hazy2go/wifi-game-boy-cartridge/README.md

# WiFi Game Boy Cartridge (Rev B)

A WiFi cartridge for the original Game Boy and the Game Boy Color that **can't brown out the console**.
An RP2350 serves the whole cartridge bus, and an ESP32-C3 radio sits behind a power stage. That stage limits what the cart takes from the console to a steady 150 mA and never pulls the console's 5 V rail below 4.588 V.
Fully assembled by JLCPCB, nothing to hand-solder. Designed by Hazy, co-created with RemAI.

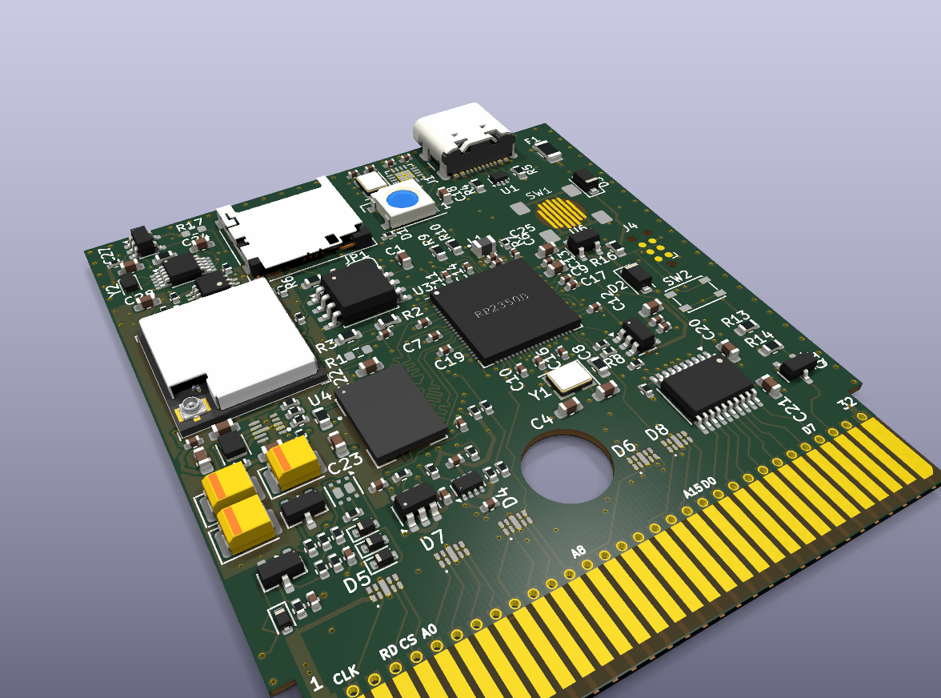
[picture p1: docs/img/board_iso.png]
Rev B board, 3D render


| | |
|---|---|
| Status (2026-10-16) | Hardware design finished, all checks green, JLC order files ready, **not ordered yet**. Bench tests on a XIAO ESP32C3 dev board are under way: RF calibration (about 30 ms at about 60 mA, looks OK), antenna (strong) and the radio app on real WiFi (all commands work) are done; the Pico 2 link test and a power-model update with the measured numbers come next. See `docs/LOGBOOK.md`. |
| Board | 6 layers, 0.8 mm, standard cartridge shell, USB-C |
| Cartridge core | RP2350B + 8 MB HyperRAM + 16 MB flash + microSD + RTC, serving the cartridge bus over PIO (the proven Croco Cartridge design) |
| Radio | ESP32-C3-MINI-1U on the RP2350's SPI bus, stick-on FPC antenna (MHF III plug) inside the shell. Both chips flash over the one USB-C port (built-in USB hub) |
| Power | USB/console power mux → 150 mA current limit → precision input-voltage regulator (console never pulled below 4.588 V ±1 %) → ~1 mF reservoir → power-good → buck-boost to 3.3 V. The radio firmware admits every WiFi frame against the energy left in the reservoir |

## Why

Earlier WiFi carts powered the radio straight from the Game Boy's 5 V. Every transmit burst (170 to 350 mA) hit the console's weak power converter, and on tired batteries the whole system collapsed.
Here the console only ever sees a steady, limited draw. The bursts come out of a local reservoir, and if the console can't keep up, the radio waits instead of the Game Boy crashing.

| Top | Bottom |
|---|---|
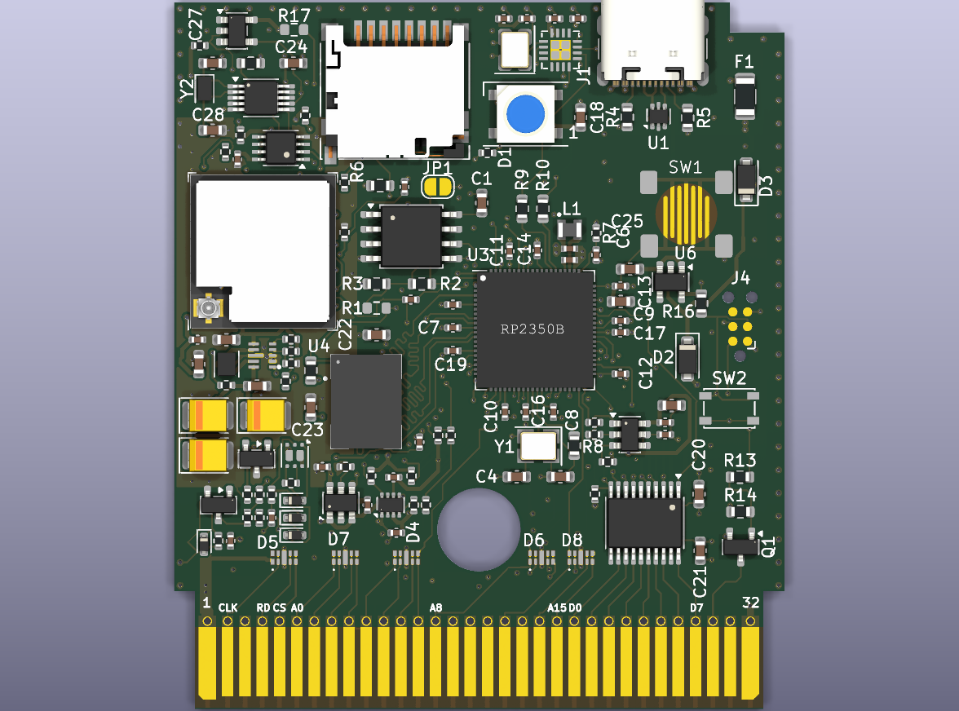
[picture p2: docs/img/board_top.png]
top
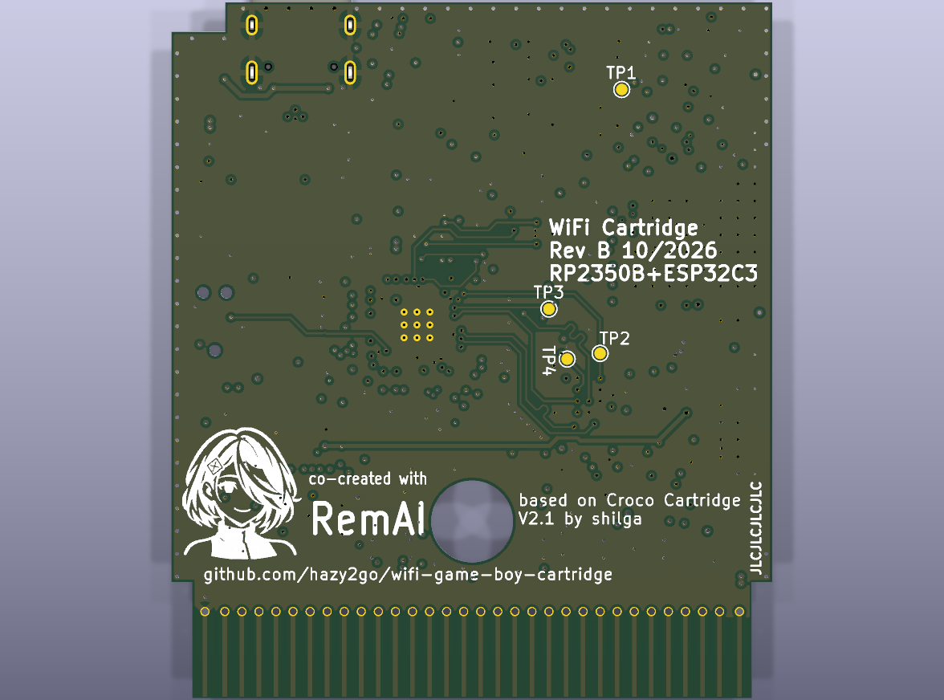
[picture p3: docs/img/board_bottom.png]
bottom
|  |  |

## Proven before ordering

None of this has been built yet. Instead, everything was simulated against real part models and checked against the actual layout:
- **Power stage, at transistor level:** ngspice with TI and Vishay vendor models, covering hot-plug, bursts after idle, loop stability and every tolerance corner (`sim/power`, audits A1 to A8).
- **Full system:** a real Game Boy ROM runs in a cycle-accurate emulator and goes through the cartridge's mailbox. The models cover the RP2350, the ESP32-C3 running the *shipped* power-manager C code, and the power plant including the routed copper's resistance. Tested on fresh, tired and weak batteries (`sim/system`).
- **Layout:**
  - KiCad ERC, DRC and connectivity are clean against the Croco baseline (`verify/`).
  - Every part is checked pin by pin against the exact JLC part.
  - The placement file is derived from JLC's own footprints.

Demo ROM in that simulation: WiFi scan (real networks seen by the host), password entry, then a live BTC/USD chart:

BTC demo running in the simulated cartridge

## Repository

| Path | What |
|---|---|
| `CLAUDE.md` | Handoff: current status, rules, software to-do (start here) |
| `docs/ARCHITECTURE.md` | Block diagram, why each block, pin budget |
| `docs/LOGBOOK.md` | Every decision, check and result, in order |
| `hw/rev-b/` | KiCad project, layout tools, `fab/` order files (`fab/ORDER.md`) |
| `docs/ROM_DEV.md` | **Building ROMs for the cart:** mailbox, commands, timing, testing |
| `gb/gbdk/`, `gb/rgbds/` | WiFi libraries for C (GBDK-2020) and assembly (RGBDS), template, examples |
| `firmware/esp32c3/` | Radio firmware: app, power manager, link protocol, shared C components |
| `firmware/xiao/` | Bench tests for the dev board (calibration time, antenna, boot time) |
| `sim/power/`, `sim/system/` | Power-stage and full-system simulations (`run_rom.py` runs any ROM on the simulated cart) |
| `verify/` | Pre-order gates |
| `legacy/` | The original ESP8266 cartridge's code, PCB and shell, kept for reference only |

## Credits

- Designed by [hazy2go](https://github.com/hazy2go), co-created with RemAI (the avatar on the back of the board).
- Forked from [Staacks/wifi-game-boy-cartridge](https://github.com/Staacks/wifi-game-boy-cartridge) (there.oughta.be). The original ESP8266 cartridge was the idea and the starting point.
- The cartridge core is [Croco Cartridge V2.1](https://github.com/shilga/rp-gameboy-cartridge-hw) by shilga. Firmware base: [rp2350-gameboy-cartridge-firmware](https://github.com/shilga/rp2350-gameboy-cartridge-firmware).
- The emulator in the simulation is [Peanut-GB](https://github.com/deltabeard/Peanut-GB). The DMG power-supply analysis uses [Gekkio's gb-schematics](https://github.com/Gekkio/gb-schematics).

## License

| What | License |
|---|---|
| Hardware design (`hw/rev-b/`: schematic, board, fab files) | CERN-OHL-P v2, inherited from Croco Cartridge (`hw/rev-b/LICENSE-CERN-OHL-P.md`) |
| Everything else here: radio firmware (`firmware/`), Game Boy libraries and examples (`gb/`), simulators (`sim/`), gates (`verify/`), board tools (`hw/rev-b/tools/`), docs | **MIT** (`LICENSE`). Permissive on purpose: ROMs built with the libraries can use any license |
| RP2350 cart firmware ([hazy2go/rp2350-gameboy-cartridge-firmware](https://github.com/hazy2go/rp2350-gameboy-cartridge-firmware)) | GPL-3, as its upstream (Croco) |
| `sim/system/third_party/Peanut-GB` | MIT (one local fix, marked in the code) |
| `sim/system/rom/font8x8_basic.h` (test ROM font) | Public domain (Daniel Hepper, after the IBM VGA font) |
| Vendor SPICE models (TI, Vishay) | Not included: `sim/models/fetch_models.py` downloads them under the vendors' terms |
| `legacy/` | The original project's licenses: GPL-3 for code and PCB, CC-BY-NC-SA for the shell (`legacy/README.md`) |
