hazy2go/wifi-game-boy-cartridge/sim/system/out/report.txt

layout parasitics: -DRPATH=0.0369 -DRESR=0.0156
# S1 full-system simulation: Game Boy ROM -> cartridge mailbox -> RP2350 -> SPI -> ESP32-C3 firmware -> power path

## fresh: console source 0.7 ohm, 12 s simulated
   | WIFI CART TEST
   | PING:
   | PONG
   | TIME (NTP):
   | 2026-10-14 15:00:00
   | GET /hello:
   | Hello from WiFi!
   | POWER:
   | RAIL 4.84V RES 4.82V
   | BURST 20/20 OK
   | POWER:
   | RAIL 4.84V RES 4.82V
   | DONE
PASS  S1.1 fresh screen: all 13 lines as expected
PASS  S1.5 fresh no wrong answer: every printed result correct or explicit ERR/TIMEOUT
PASS  S1.2 fresh console rail: min 4.783 V, 0.0 ms below 4.5 V
PASS  S1.3 fresh radio resets: 0; reservoir min while on 4.20 V
PASS  S1.4 fresh TX through power manager: 129 data frames sent, 129 admitted, refused-ms 0, dropped 0 (TCP retransmit), 5 library frames unadmitted, 1 connects, parks 0

## tired: console source 1.2 ohm, 12 s simulated
   | WIFI CART TEST
   | PING:
   | PONG
   | TIME (NTP):
   | 2026-10-14 15:00:00
   | GET /hello:
   | Hello from WiFi!
   | POWER:
   | RAIL 4.73V RES 4.71V
   | BURST 20/20 OK
   | POWER:
   | RAIL 4.73V RES 4.71V
   | DONE
PASS  S1.1 tired screen: all 13 lines as expected
PASS  S1.5 tired no wrong answer: every printed result correct or explicit ERR/TIMEOUT
PASS  S1.2 tired console rail: min 4.628 V, 0.0 ms below 4.5 V
PASS  S1.3 tired radio resets: 0; reservoir min while on 4.20 V
PASS  S1.4 tired TX through power manager: 129 data frames sent, 129 admitted, refused-ms 0, dropped 0 (TCP retransmit), 5 library frames unadmitted, 1 connects, parks 0

## weak: console source 2.0 ohm, 20 s simulated
   | WIFI CART TEST
   | PING:
   | PONG
   | TIME (NTP):
   | 2026-10-14 15:00:00
   | GET /hello:
   | Hello from WiFi!
   | POWER:
   | RAIL 4.59V RES 3.51V
   | BURST 20/20 OK
   | POWER:
   | RAIL 4.59V RES 3.50V
   | DONE
PASS  S1.1 weak screen: all 13 lines as expected
PASS  S1.5 weak no wrong answer: every printed result correct or explicit ERR/TIMEOUT
PASS  S1.2 weak console rail: min 4.591 V, 0.0 ms below 4.5 V
PASS  S1.3 weak radio resets: 0; reservoir min while on 3.31 V
PASS  S1.4 weak TX through power manager: 129 data frames sent, 129 admitted, refused-ms 1864, dropped 0 (TCP retransmit), 5 library frames unadmitted, 1 connects, parks 0

## weak_plus: console source 2.5 ohm, 60 s simulated
   | WIFI CART TEST
   | PING:
   | ERR
   | TIME (NTP):
   | ERR
   | GET /hello:
   | ERR
   | POWER:
   | ERR
   | BURST FAIL
   | POWER:
   | ERR
   | DONE
INFO  S1.1 weak_plus: not complete; radio resets 107 (boot energy at the default assumption, see weak_plus_fastboot)
PASS  S1.5 weak_plus no wrong answer: every printed result correct or explicit ERR/TIMEOUT
PASS  S1.2 weak_plus console rail: min 4.588 V, 0.0 ms below 4.5 V

## S1.6 SPI link with bit errors on MOSI and MISO (fresh console)
PASS  S1.6 BER 1e-4 screen: 281 bit errors, 463 bad headers, 0 bad bodies, ESP rejected 135, 30 requests re-sent; all 13 lines as expected

## S1.7 a ROM without the WIFICART opt-in gets no mailbox
PASS  S1.7 no opt-in: wifi_rom 0, 0 SPI transactions, 0 cart writes to bank 15
PASS  S1.7 WIFICART with 32 KB RAM: wifi_rom 0, 0 SPI transactions

## S1.8 shipped formatter / TX sizing (components/gbwifi) host test
   | PASS: 0 failures
PASS  S1.8 gbwifi: scan lines <= 19 columns, connect parsing, airtime, power/time/BTC text

## S1.9 GBDK-2020 library (gb/gbdk): demo ROM on the fresh and weak consoles
   | GBDK WIFI DEMO
   | PING:
   | PONG
   | TIME:
   | 2026-10-14 15:00:00
   | GET /hello:
   | Hello from WiFi!
   | POWER:
   | RAIL 4.84V RES 4.82V
   | DONE
PASS  S1.9 gbdk_fresh: screen as expected; console min 4.783 V, resets 0, 9 frames all admitted
   | GBDK WIFI DEMO
   | PING:
   | PONG
   | TIME:
   | 2026-10-14 15:00:00
   | GET /hello:
   | Hello from WiFi!
   | POWER:
   | RAIL 4.59V RES 3.51V
   | DONE
PASS  S1.9 gbdk_weak: screen as expected; console min 4.591 V, resets 0, 9 frames all admitted

## S1.10 ADC error: the reservoir reads 2.5 % high (admission too generous), the rail 1 % high, weak consoles (fast boot, as S1.11)
PASS  S1.10 weak_adc: resets 0, reservoir min 3.19 V, console min 4.591 V
PASS  S1.10 weak_plus_adc: resets 0, reservoir min 2.38 V, console min 4.588 V

## S1.11 weak_plus (2.5 ohm) with a fast ESP boot: 100 ms at 20 mA to app_main (app sdkconfig fast boot; measure on the XIAO)
PASS  S1.11 weak_plus_fastboot: screen complete; resets 0, 129 frames, drops 0, parks 144, console min 4.588 V

## S1.12 developer kit: RGBDS library example and GBDK template through run_rom.py (docs/ROM_DEV.md)
PASS  S1.12 rgbds example (weak): PASS
PASS  S1.12 gbdk template (weak): PASS

RESULT: ALL PASS
