hazy2go/wifi-game-boy-cartridge/docs/img/board_top_after_lift.png

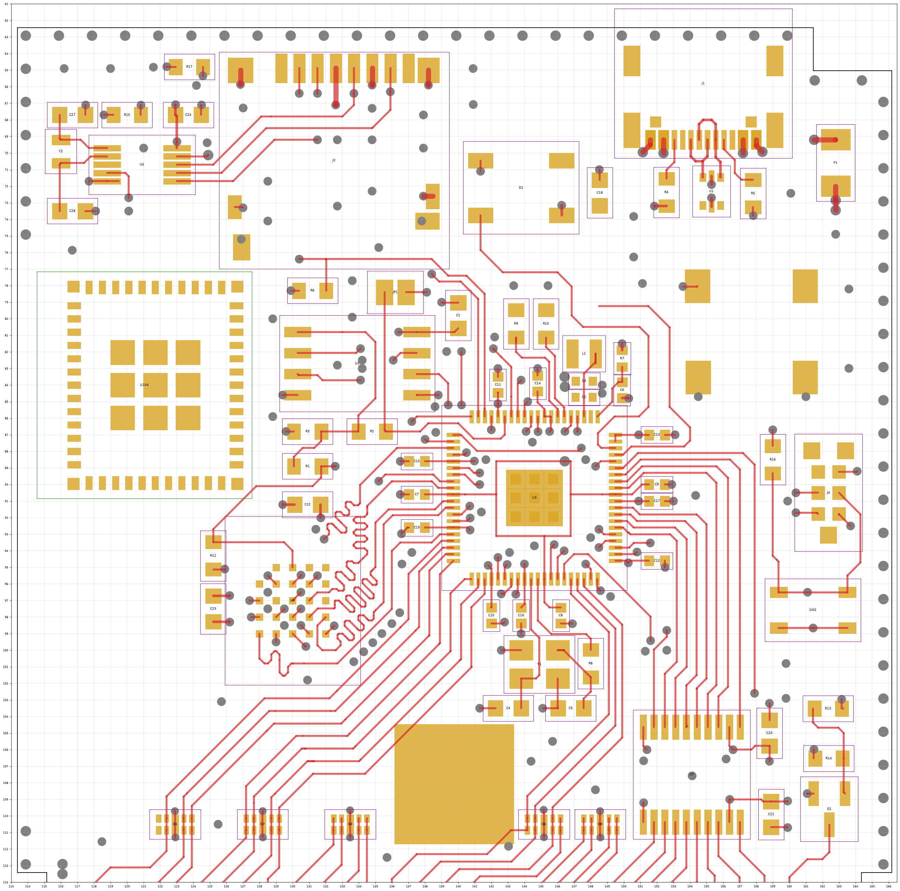
docs/img/board_top_after_lift.png
