hazy2go/wifi-game-boy-cartridge/docs/img/free_space_after_lift.png

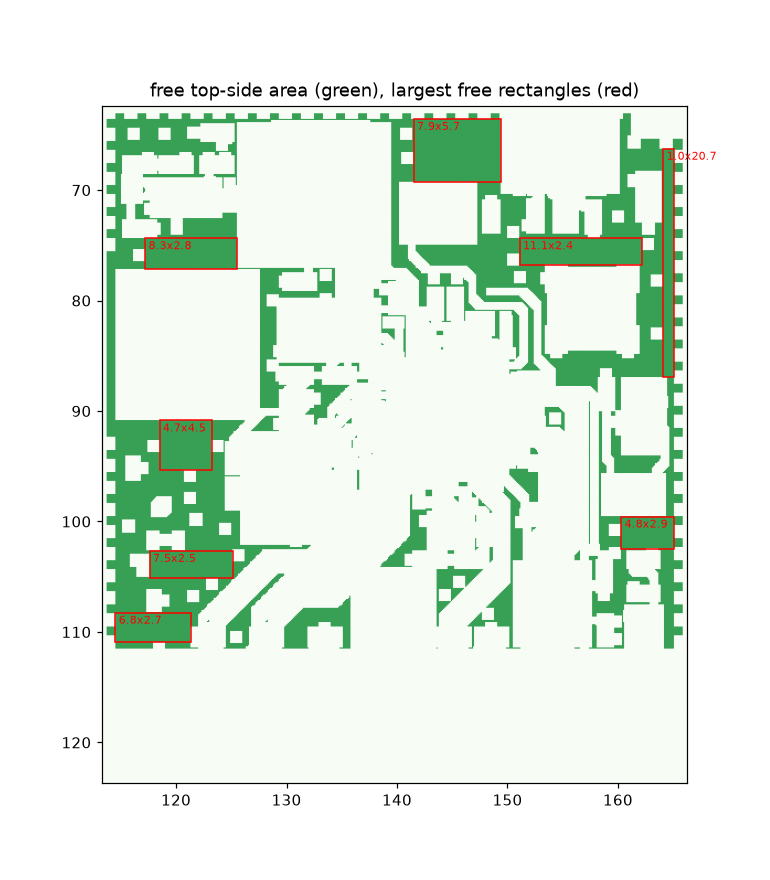
docs/img/free_space_after_lift.png
