hazy2go/wifi-game-boy-cartridge/docs/img/placement_v1.png

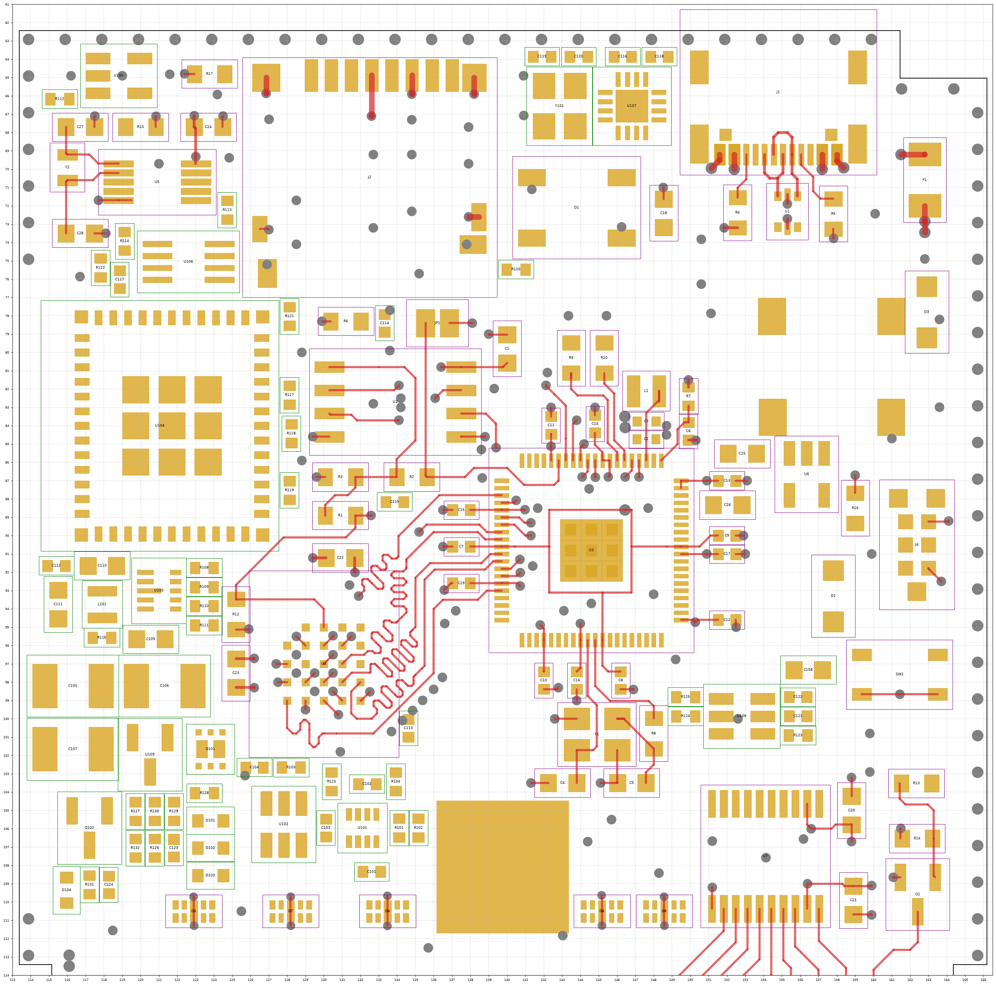
docs/img/placement_v1.png
