hazy2go/wifi-game-boy-cartridge/sim/power/plot_stress_50pct.png

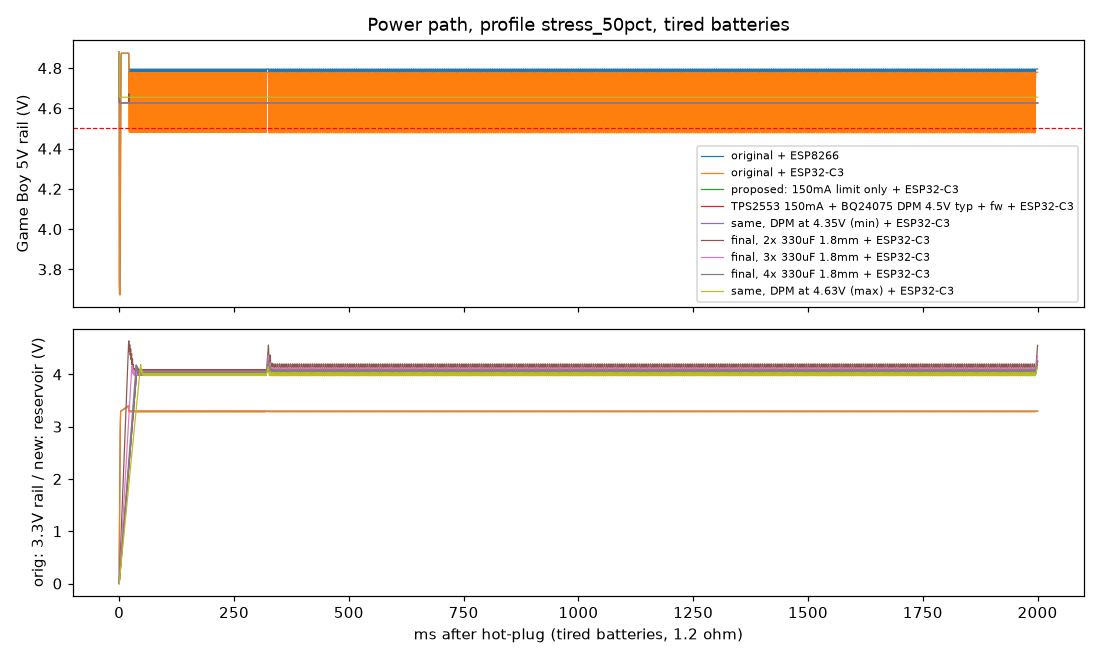
sim/power/plot_stress_50pct.png
