hazy2go/wifi-game-boy-cartridge/sim/power/plot_traffic_2ms_20pct.png

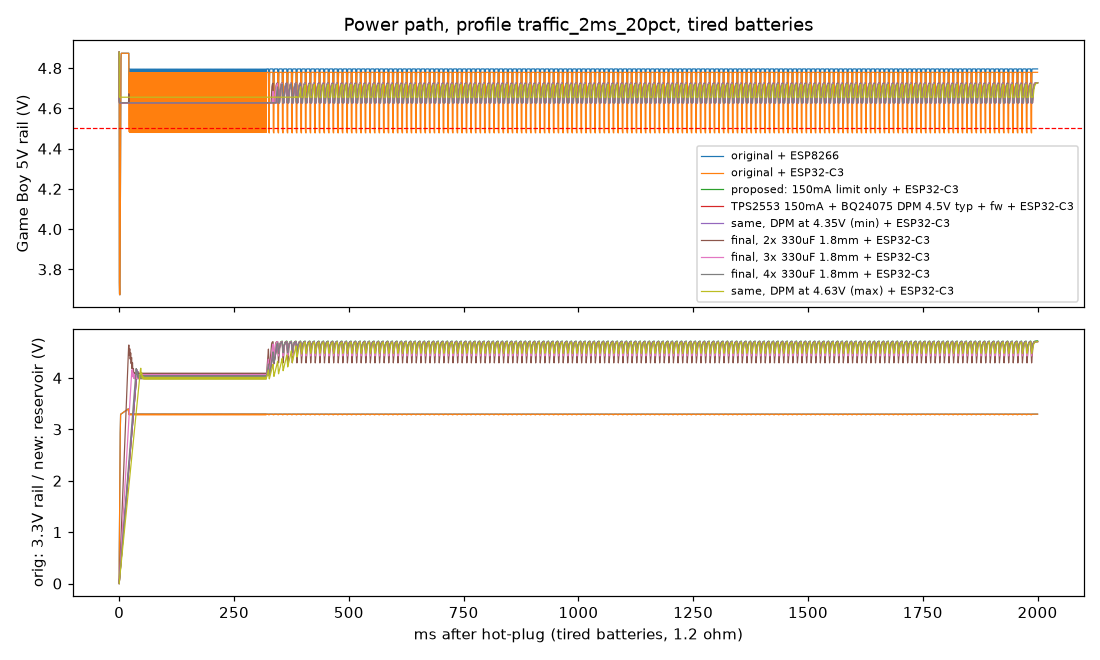
sim/power/plot_traffic_2ms_20pct.png
