hazy2go/wifi-game-boy-cartridge/sim/power/plot_worst_11b_12ms.png

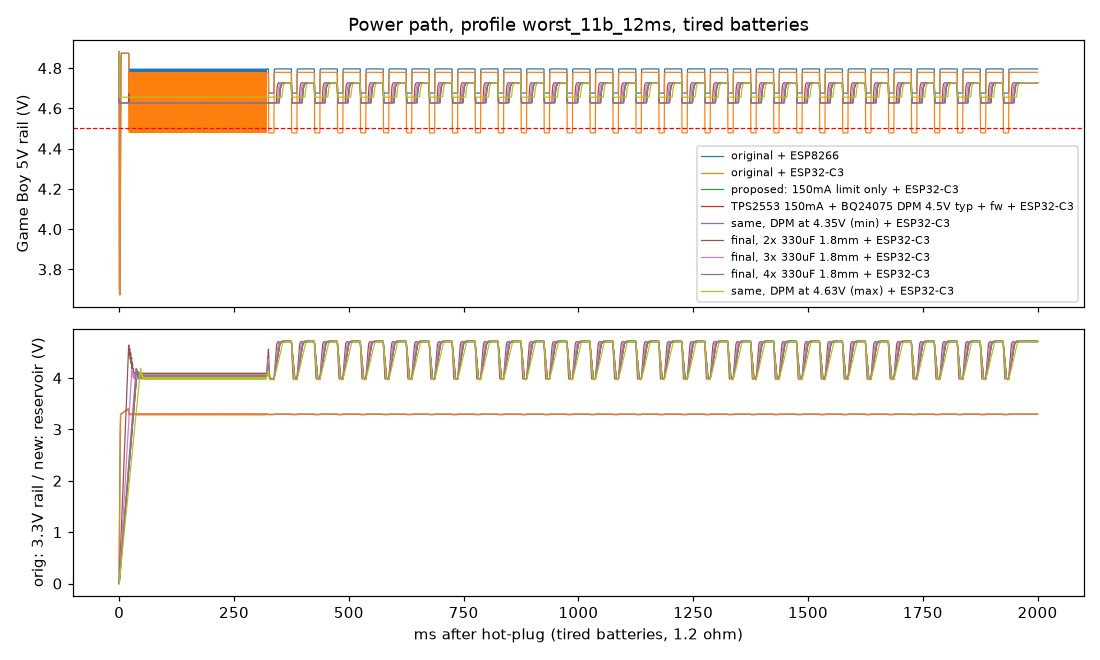
sim/power/plot_worst_11b_12ms.png
