hazy2go/wifi-game-boy-cartridge/sim/system/out/demo_01_s1.png

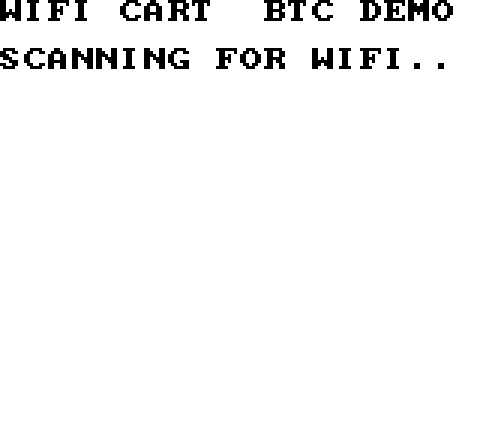
sim/system/out/demo_01_s1.png
