hazy2go/wifi-game-boy-cartridge/sim/system/out/demo_02_s2.png

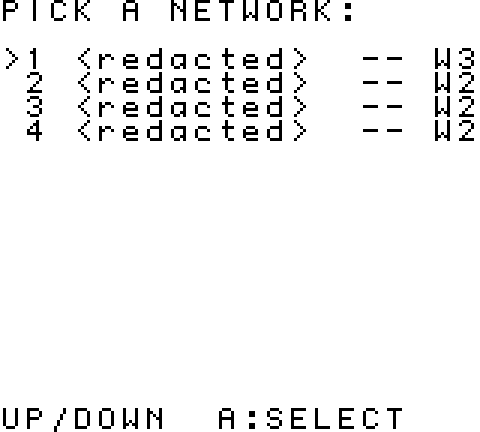
sim/system/out/demo_02_s2.png
