hazy2go/wifi-game-boy-cartridge/sim/system/out/demo_04_s3.png

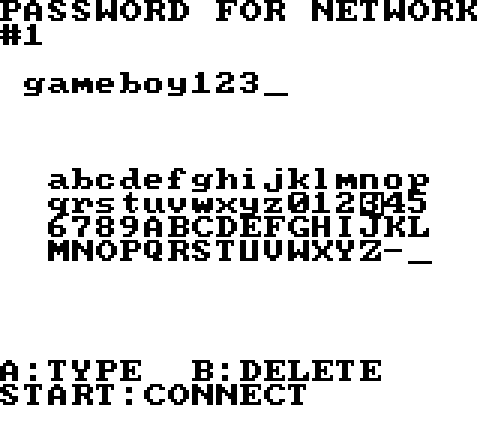
sim/system/out/demo_04_s3.png
