hazy2go/wifi-game-boy-cartridge/sim/system/out/demo_07_s5.png

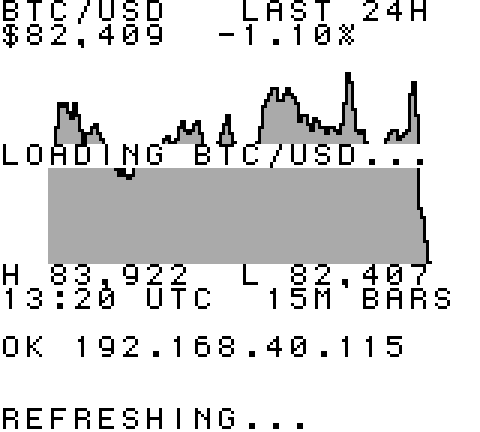
sim/system/out/demo_07_s5.png
