hazy2go/wifi-game-boy-cartridge/sim/system/out/demo_08_s6.png

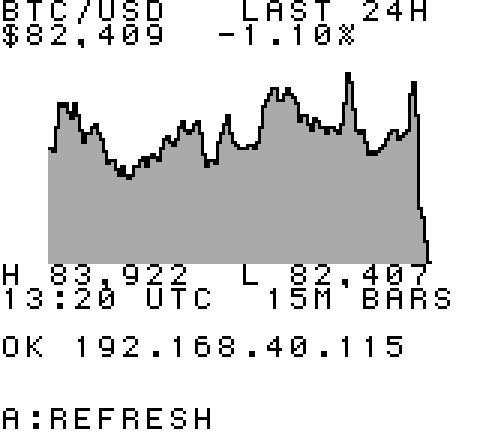
sim/system/out/demo_08_s6.png
