hazy2go/wifi-game-boy-cartridge/sim/system/out/demo_grid.png

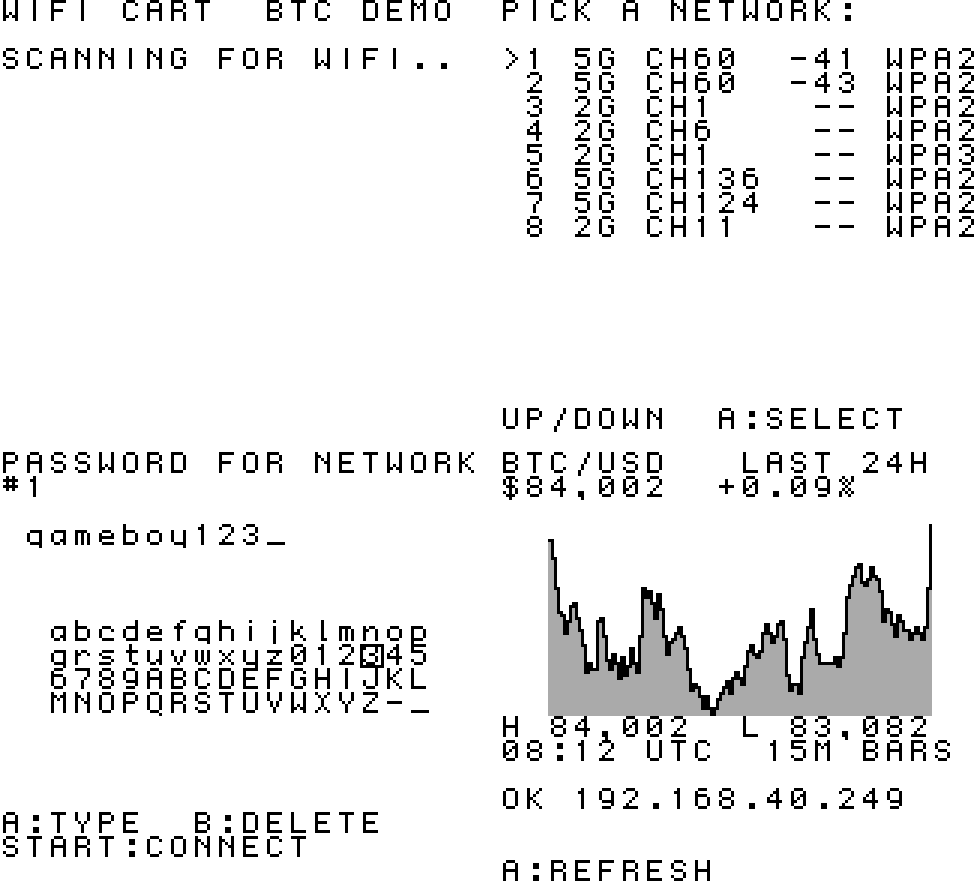
sim/system/out/demo_grid.png
