hazy2go/wifi-game-boy-cartridge/sim/system/out/demo_screen.png

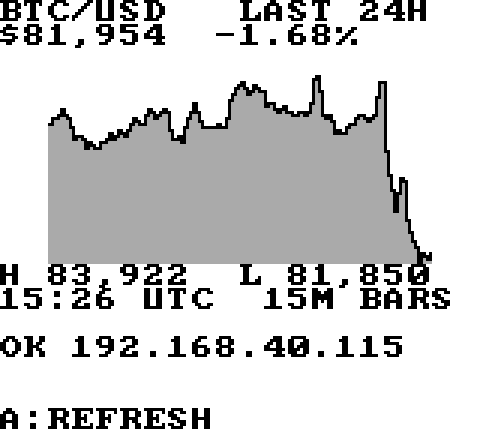
sim/system/out/demo_screen.png
