hazy2go/wifi-game-boy-cartridge/sim/system/out/fresh_screen.png

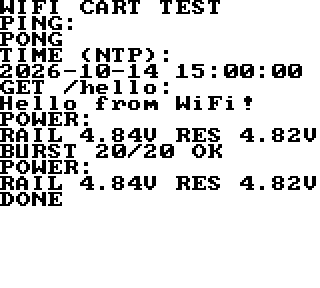
sim/system/out/fresh_screen.png
