hazy2go/wifi-game-boy-cartridge/sim/system/out/kit_template/screen.png

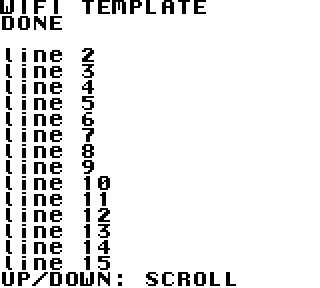
sim/system/out/kit_template/screen.png
