hazy2go/wifi-game-boy-cartridge/sim/system/out/soak_fresh/screen.png

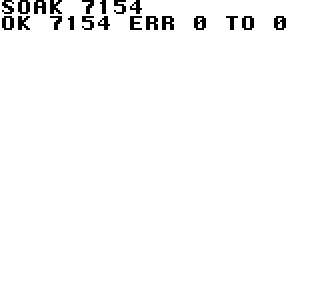
sim/system/out/soak_fresh/screen.png
