hazy2go/wifi-game-boy-cartridge/sim/system/out/tired_screen.png

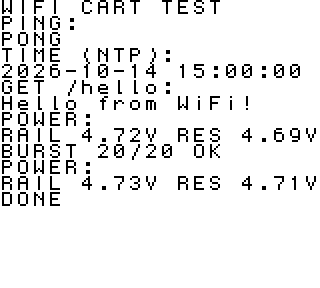
sim/system/out/tired_screen.png
