hazy2go/wifi-game-boy-cartridge/sim/system/out/weak_plus_screen.png

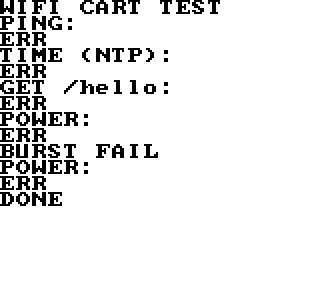
sim/system/out/weak_plus_screen.png
