hazy2go/wifi-game-boy-cartridge/hw/rev-b/fab/GameboyCartridgeV2.1-BOM-JLC.csv

Comment | Designator | Footprint | LCSC Part #
100nF | C1,C18,C20,C21,C22,C23,C24 | C_0603_1608Metric | C14663
4.7u | C2,C3 | C_0402_1005Metric_small_pads | C23733
15pF | C4,C5 | C_0603_1608Metric | C1644
4.7u | C6,C8 | C_0402_1005Metric | C23733
100n | C7,C9,C10,C11,C12,C13,C14,C15,C16,C17,C19 | C_0402_1005Metric | C1525
1uF | C25,C26 | C_0603_1608Metric | C15849
4.3pF | C27,C28 | C_0603_1608Metric | C59526
1uF 25V X5R | C101,C102,C103,C104,C118,C119 | C_0402_1005Metric | C52923
330uF 6.3V 40mOhm T520B337M006ATE040 | C105,C106,C107 | CP_EIA-3528-21_Kemet-B | C696806
10uF 10V X5R | C108,C109,C111 | C_0603_1608Metric | C19702
22uF 6.3V X5R | C110 | C_0603_1608Metric | C59461
100nF 16V X7R | C112,C113,C116,C117,C120,C122,C124 | C_0402_1005Metric | C1525
2.2nF 50V X7R | C114,C115 | C_0402_1005Metric | C84703
10nF 50V X7R | C121 | C_0402_1005Metric | C15195
470pF 50V C0G | C123 | C_0402_1005Metric | C76971
WS2812B | D1 | LED_WS2812B_PLCC4_5.0x5.0mm_P3.2mm | C2761795
D_Schottky | D2,D3 | D_SOD-123F | C669022
1N4148WT | D101,D102,D103,D104 | D_SOD-523 | C27748
Polyfuse | F1 | Fuse_1206_3216Metric | C2649911
USB_C_Receptacle_USB2.0 | J1 | USB_C_Receptacle_GCT_USB4105-xx-A_16P_TopMnt_Horizontal | C2927037
Micro_SD_Card_Det2 | J2 | microSD_HC_Hirose_DM3D-SF | C719027
3.3u | L1 | L_pol_2016 | C42411119
0.47uH 5.5A 26mOhm DFE201612E-R47M | L101 | L_Murata_DFE201610P | C668312
CJ2302 | Q1 | SOT-23 | C8548
SIA975DJ-T1-GE3 | Q101 | Vishay_PowerPAK_SC70-6L_Dual | C141597
2N7002 | Q102 | SOT-23 | C8545
0R | R2 | R_0603_1608Metric | C21189
10k | R3,R6,R12,R14,R15,R16 | R_0603_1608Metric | C25804
5k1 | R4,R5 | R_0603_1608Metric | C23186
33 | R7 | R_0402_1005Metric | C25105
1k | R8,R13 | R_0603_1608Metric | C21190
27R | R9,R10 | R_0603_1608Metric | C25190
1.3k 1% | R101 | R_0402_1005Metric | C25866
510 1% | R102 | R_0402_1005Metric | C25123
180k 1% | R103 | R_0402_1005Metric | C25760
100k 1% | R104,R115 | R_0402_1005Metric | C25741
10k 1% | R108,R111,R112,R113,R114 | R_0402_1005Metric | C25744
511k 1% | R109 | R_0402_1005Metric | C64042
91k 1% | R110 | R_0402_1005Metric | C453777
680k 1% | R116,R118 | R_0402_1005Metric | C4131
200k 1% | R117,R119 | R_0402_1005Metric | C25764
22R 1% | R120,R121 | R_0402_1005Metric | C25092
33R 1% | R122 | R_0402_1005Metric | C25105
1.3M 1% | R123 | R_0402_1005Metric | C423245
1.0M 1% | R124 | R_0402_1005Metric | C26083
1.2M 1% | R125 | R_0402_1005Metric | C43675
27.0k 0.1% | R126 | R_0402_1005Metric | C723421
10.0k 0.1% | R127 | R_0402_1005Metric | C190095
680 1% | R128,R129 | R_0402_1005Metric | C137948
330k 1% | R130 | R_0402_1005Metric | C25778
470k 1% | R131 | R_0402_1005Metric | C25790
1k 1% | R132 | R_0402_1005Metric | C11702
4.7k | R133 | R_0402_1005Metric | C25900
USBLC6-2P6 | U1 | SOT-666 | C2827693
W25Q128JVSIQ | U2 | SOIC-8_5.23x5.23mm_P1.27mm | C97521
RP2350_80QFN | U3 | RP2350-QFN-80-1EP_10x10_P0.4mm_EP3.4x3.4mm_ThermalVias | C42415655
IS66WVH8M8BLL-100B1LI | U4 | BGA25C100P5X5_800X600X120N | C1349096
MCP79510 | U5 | MSOP-10_3x3mm_P0.5mm | C627708
AP2112K-3.3 | U6 | SOT-23-5 | C51118
TXB0108PW | U7 | TSSOP-20_4.4x6.5mm_P0.65mm | C53406
TPS2116DRLR | U101 | SOT-583-8 | C3235557
TPS2553DBVR | U102 | SOT-23-6 | C55266
TPS63802DLAR | U103 | TI_DLA0010A_VSON-HR-10_2x3mm_P0.5mm | C2845237
ESP32-C3-MINI-1U-N4 | U104 | ESP32-C3-MINI-1U | C2911374
SN74LVC1G125DBVR | U105 | SOT-23-5 | C23654
SN74LVC3G34DCTR | U106 | SSOP-8_2.95x2.8mm_P0.65mm | C139356
CH334P | U107 | QFN-16-1EP_3x3mm_P0.5mm_EP1.75x1.75mm | C5373042
TLV3012BIDBVR | U108 | SOT-23-6 | C20345924
TLV431BIDBZR | U109 | SOT-23 | C398375
12MHz | Y1 | Crystal_SMD_TXC_7M-4Pin_3.2x2.5mm | C20625731
32.768kHz | Y2 | Crystal_SMD_TXC_9HT11-2Pin_2.0x1.2mm | C97602
12MHz 10pF | Y101 | Crystal_SMD_3225-4Pin_3.2x2.5mm | C20625731
