hazy2go/wifi-game-boy-cartridge/hw/rev-b/fab/bom_check.txt

BOM check for 2 boards: 72 lines, 130 placed parts, 44 extended parts (feeder fee each), DNP: D4,D5,D6,D7,D8, R1, R17

ok   C14663    base   stock  49892442 need   19  100nF              C1,C18,C20,C21,C22,C23,C24               CC0603KRX7R9BB104      
ok   C23733    base   stock   1837825 need    9  4.7u               C2,C3                                    CL05A475MP5NRNC        
ok   C1644     base   stock    981474 need    9  15pF               C4,C5                                    CL10C150JB8NNNC        
ok   C23733    base   stock   1837825 need    9  4.7u               C6,C8                                    CL05A475MP5NRNC        
ok   C1525     base   stock  22144960 need   27  100n               C7,C9,C10,C11,C12,C13,C14,C15,C16,C17,C1 CL05B104KO5NNNC        
ok   C15849    base   stock   9711805 need    9  1uF                C25,C26                                  CL10A105KB8NNNC        
ok   C59526    expand stock     24714 need    9  4.3pF              C27,C28                                  0603CG4R3C500NT        
ok   C52923    base   stock   9563534 need   17  1uF 25V X5R        C101,C102,C103,C104,C118,C119            CL05A105KA5NQNC        
ok   C696806   expand stock      7913 need   11  330uF 6.3V 40mOhm  C105,C106,C107                           T520B337M006ATE040     
ok   C19702    base   stock  10669029 need   11  10uF 10V X5R       C108,C109,C111                           CL10A106KP8NNNC        
ok   C59461    base   stock   7233393 need    7  22uF 6.3V X5R      C110                                     CL10A226MQ8NRNC        
ok   C1525     base   stock  22144960 need   19  100nF 16V X7R      C112,C113,C116,C117,C120,C122,C124       CL05B104KO5NNNC        
ok   C84703    expand stock     84393 need    9  2.2nF 50V X7R      C114,C115                                CL05B222KB5NNNC        
ok   C15195    base   stock   6309426 need    7  10nF 50V X7R       C121                                     CL05B103KB5NNNC        
ok   C76971    expand stock    374577 need    7  470pF 50V C0G      C123                                     GRM1555C1H471JA01D     
ok   C2761795  expand stock     36809 need    7  WS2812B            D1                                       WS2812B-B/T            
ok   C669022   expand stock      8492 need    9  D_Schottky         D2,D3                                    SM5817PL-TP            
ok   C27748    expand stock     79501 need   13  1N4148WT           D101,D102,D103,D104                      1N4148WT               
ok   C2649911  expand stock      8518 need    7  Polyfuse           F1                                       NANOSMDC050F/13.2-2    
ok   C2927037  expand stock      2336 need    7  USB_C_Receptacle_U J1                                       USB-TYPE-C-017         
ok   C719027   expand stock      4305 need    7  Micro_SD_Card_Det2 J2                                       DM3D-SF                
FAIL C42411119 expand stock         4 need    7  3.3u               L1                                       AOTA-B201610S3R3-101-T STOCK 4 < 7
ok   C668312   expand stock     12140 need    7  0.47uH 5.5A 26mOhm L101                                     DFE201612E-R47M=P2     
ok   C8548     expand stock     62370 need    7  CJ2302             Q1                                       CJ2302 S2              
ok   C141597   expand stock      2692 need    7  SIA975DJ-T1-GE3    Q101                                     SIA975DJ-T1-GE3        
ok   C8545     base   stock   2173372 need    7  2N7002             Q102                                     2N7002                 
ok   C21189    base   stock  23957650 need    7  0R                 R2                                       0603WAF0000T5E         
ok   C25804    base   stock  31846388 need   17  10k                R3,R6,R12,R14,R15,R16                    0603WAF1002T5E         
ok   C23186    base   stock  23703178 need    9  5k1                R4,R5                                    0603WAF5101T5E         
ok   C25105    base   stock   1399209 need    7  33                 R7                                       0402WGF330JTCE         
ok   C21190    base   stock  23875116 need    9  1k                 R8,R13                                   0603WAF1001T5E         
ok   C25190    expand stock     63937 need    9  27R                R9,R10                                   0603WAF270JT5E         
ok   C25866    expand stock     61261 need    7  1.3k 1%            R101                                     0402WGF1301TCE         
ok   C25123    base   stock   1674995 need    7  510 1%             R102                                     0402WGF5100TCE         
ok   C25760    expand stock    171341 need    7  180k 1%            R103                                     0402WGF1803TCE         
ok   C25741    base   stock   9660544 need    9  100k 1%            R104,R115                                0402WGF1003TCE         
ok   C25744    base   stock  21754993 need   15  10k 1%             R108,R111,R112,R113,R114                 0402WGF1002TCE         
ok   C64042    expand stock    168183 need    7  511k 1%            R109                                     0402WGF5113TCE         
ok   C453777   expand stock    119657 need    7  91k 1%             R110                                     RC-02K9102FT           
ok   C4131     expand stock    186832 need    9  680k 1%            R116,R118                                0402WGF6803TCE         
ok   C25764    base   stock   2118449 need    9  200k 1%            R117,R119                                0402WGF2003TCE         
ok   C25092    base   stock   4060234 need    9  22R 1%             R120,R121                                0402WGF220JTCE         
ok   C25105    base   stock   1399209 need    7  33R 1%             R122                                     0402WGF330JTCE         
ok   C423245   expand stock      5439 need    7  1.3M 1%            R123                                     0402WGF1304TCE         
ok   C26083    base   stock   2036818 need    7  1.0M 1%            R124                                     0402WGF1004TCE         
ok   C43675    expand stock     12495 need    7  1.2M 1%            R125                                     0402WGF1204TCE         
ok   C723421   expand stock      4846 need    7  27.0k 0.1%         R126                                     RT0402BRD0727KL        
ok   C190095   expand stock    582253 need    7  10.0k 0.1%         R127                                     RT0402BRD0710KL        
ok   C137948   expand stock    784164 need    9  680 1%             R128,R129                                RC0402FR-07680RL       
ok   C25778    expand stock    129882 need    7  330k 1%            R130                                     0402WGF3303TCE         
ok   C25790    expand stock    183004 need    7  470k 1%            R131                                     0402WGF4703TCE         
ok   C11702    base   stock  14269830 need    7  1k 1%              R132                                     0402WGF1001TCE         
ok   C25900    base   stock  16053025 need    7  4.7k               R133                                     0402WGF4701TCE         
ok   C2827693  expand stock     39298 need    7  USBLC6-2P6         U1                                       USBLC6-2P6             
ok   C97521    base   stock     65890 need    7  W25Q128JVSIQ       U2                                       W25Q128JVSIQ           
ok   C42415655 expand stock      4922 need    7  RP2350_80QFN       U3                                       RP2350B                
ok   C1349096  expand stock       919 need    7  IS66WVH8M8BLL-100B U4                                       IS66WVH8M8BLL-100B1LI  
ok   C627708   expand stock       230 need    7  MCP79510           U5                                       MCP79510T-I/MS         
ok   C51118    expand stock     10508 need    7  AP2112K-3.3        U6                                       AP2112K-3.3TRG1        
ok   C53406    expand stock     28944 need    7  TXB0108PW          U7                                       TXB0108PWR             
ok   C3235557  expand stock     70296 need    7  TPS2116DRLR        U101                                     TPS2116DRLR            
ok   C55266    expand stock     54162 need    7  TPS2553DBVR        U102                                     TPS2553DBVR            
ok   C2845237  expand stock     40342 need    7  TPS63802DLAR       U103                                     TPS63802DLAR           
ok   C2911374  expand stock      1700 need    7  ESP32-C3-MINI-1U-N U104                                     ESP32-C3-MINI-1U-N4    
ok   C23654    expand stock     52783 need    7  SN74LVC1G125DBVR   U105                                     SN74LVC1G125DBVR       
ok   C139356   expand stock      1427 need    7  SN74LVC3G34DCTR    U106                                     SN74LVC3G34DCTR        
ok   C5373042  expand stock     26355 need    7  CH334P             U107                                     CH334P                 
ok   C20345924 expand stock      1854 need    7  TLV3012BIDBVR      U108                                     TLV3012BIDBVR          
ok   C398375   expand stock     14849 need    7  TLV431BIDBZR       U109                                     TLV431BIDBZR           
ok   C20625731 expand stock      6188 need    7  12MHz              Y1                                       ABM8-272-T3            
ok   C97602    expand stock     11540 need    7  32.768kHz          Y2                                       SC-20S,32.768kHz,20PPM 
ok   C20625731 expand stock      6188 need    7  12MHz 10pF         Y101                                     ABM8-272-T3            

RESULT: 1 FAIL
