hazy2go/wifi-game-boy-cartridge/hw/rev-b/CrovoV2.step/TFBGA24_6X8_WIN.step

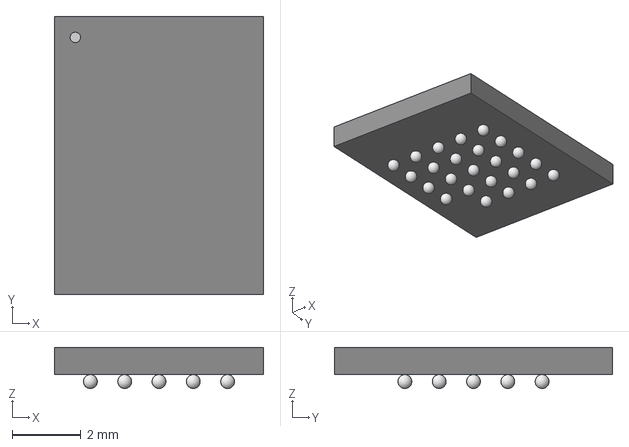
[picture p26: CAD file, 2026-10-14]
hw/rev-b/CrovoV2.step/TFBGA24_6X8_WIN.step
6.10 x 8.10 x 1.20 mm
