hazy2go/wifi-game-boy-cartridge/hw/rev-b/CrovoV2.step/ESD8008MUTAG.step

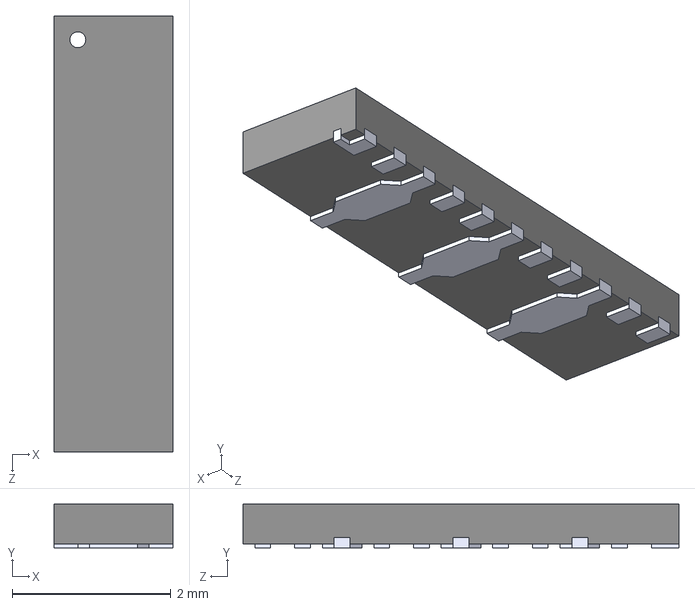
[picture p27: CAD file, 2026-10-13]
hw/rev-b/CrovoV2.step/ESD8008MUTAG.step
1.50 x 0.55 x 5.50 mm
