hazy2go/wifi-game-boy-cartridge/sim/power/results_round4_bq_variants.txt

design    chip      profile            cons   GBmin GB<4.5V ms rail/res min TX delivered radio up ms
original  ESP8266   traffic_2ms_20pct  fresh   4.23        2.5         3.29         100%           -
original  ESP32-C3  traffic_2ms_20pct  fresh   4.23        2.5         3.28         100%           -
lim150    ESP32-C3  traffic_2ms_20pct  fresh   4.78        0.0         3.99          99%          39
dpm45ps   ESP32-C3  traffic_2ms_20pct  fresh   4.78        0.0         3.99          99%          39
bq100     ESP32-C3  traffic_2ms_20pct  fresh   4.82        0.0         3.95          34%          62
bq100lo   ESP32-C3  traffic_2ms_20pct  fresh   4.82        0.0         3.95          34%          62
bq500     ESP32-C3  traffic_2ms_20pct  fresh   4.59        0.0         4.49         100%          14
final     ESP32-C3  traffic_2ms_20pct  fresh   4.78        0.0         3.99          99%          39
final_lo  ESP32-C3  traffic_2ms_20pct  fresh   4.78        0.0         3.99          99%          39
final_hi  ESP32-C3  traffic_2ms_20pct  fresh   4.78        0.0         3.99          99%          39
original  ESP8266   worst_11b_12ms     fresh   4.23        2.5         3.29         100%           -
original  ESP32-C3  worst_11b_12ms     fresh   4.23        2.5         3.28         100%           -
lim150    ESP32-C3  worst_11b_12ms     fresh   4.78        0.0         3.98          80%          39
dpm45ps   ESP32-C3  worst_11b_12ms     fresh   4.78        0.0         3.98          80%          39
bq100     ESP32-C3  worst_11b_12ms     fresh   4.82        0.0         3.93          33%          62
bq100lo   ESP32-C3  worst_11b_12ms     fresh   4.82        0.0         3.93          33%          62
bq500     ESP32-C3  worst_11b_12ms     fresh   4.59        0.0         4.49         100%          14
final     ESP32-C3  worst_11b_12ms     fresh   4.78        0.0         3.98          79%          39
final_lo  ESP32-C3  worst_11b_12ms     fresh   4.78        0.0         3.98          79%          39
final_hi  ESP32-C3  worst_11b_12ms     fresh   4.78        0.0         3.98          79%          39
original  ESP8266   stress_50pct       fresh   4.23        2.5         3.29         100%           -
original  ESP32-C3  stress_50pct       fresh   4.23        2.5         3.28         100%           -
lim150    ESP32-C3  stress_50pct       fresh   4.78        0.0         3.98          62%          39
dpm45ps   ESP32-C3  stress_50pct       fresh   4.78        0.0         3.98          62%          39
bq100     ESP32-C3  stress_50pct       fresh   4.82        0.0         3.94          13%          62
bq100lo   ESP32-C3  stress_50pct       fresh   4.82        0.0         3.94          13%          62
bq500     ESP32-C3  stress_50pct       fresh   4.59        0.0         4.49         100%          14
final     ESP32-C3  stress_50pct       fresh   4.78        0.0         3.98          62%          39
final_lo  ESP32-C3  stress_50pct       fresh   4.78        0.0         3.98          62%          39
final_hi  ESP32-C3  stress_50pct       fresh   4.78        0.0         3.98          62%          39
original  ESP8266   traffic_2ms_20pct  tired   3.67        3.1         3.29         100%           -
original  ESP32-C3  traffic_2ms_20pct  tired   3.67      353.2         3.28         100%           -
lim150    ESP32-C3  traffic_2ms_20pct  tired   4.63        0.0         3.99          99%          39
dpm45ps   ESP32-C3  traffic_2ms_20pct  tired   4.63        0.0         3.99          99%          39
bq100     ESP32-C3  traffic_2ms_20pct  tired   4.69        0.0         3.95          34%          62
bq100lo   ESP32-C3  traffic_2ms_20pct  tired   4.69        0.0         3.95          34%          62
bq500     ESP32-C3  traffic_2ms_20pct  tired   4.54        0.0         4.15         100%          27
final     ESP32-C3  traffic_2ms_20pct  tired   4.63        0.0         3.99          99%          39
final_lo  ESP32-C3  traffic_2ms_20pct  tired   4.63        0.0         3.99          99%          39
final_hi  ESP32-C3  traffic_2ms_20pct  tired   4.66        0.0         3.98          98%          46
original  ESP8266   worst_11b_12ms     tired   3.67        3.1         3.29         100%           -
original  ESP32-C3  worst_11b_12ms     tired   3.67      473.0         3.28         100%           -
lim150    ESP32-C3  worst_11b_12ms     tired   4.63        0.0         3.98          72%          39
dpm45ps   ESP32-C3  worst_11b_12ms     tired   4.63        0.0         3.98          72%          39
bq100     ESP32-C3  worst_11b_12ms     tired   4.69        0.0         3.93          33%          62
bq100lo   ESP32-C3  worst_11b_12ms     tired   4.69        0.0         3.93          33%          62
bq500     ESP32-C3  worst_11b_12ms     tired   4.54        0.0         4.03          99%          27
final     ESP32-C3  worst_11b_12ms     tired   4.63        0.0         3.98          71%          39
final_lo  ESP32-C3  worst_11b_12ms     tired   4.63        0.0         3.98          71%          39
final_hi  ESP32-C3  worst_11b_12ms     tired   4.66        0.0         3.97          61%          46
original  ESP8266   stress_50pct       tired   3.67        3.1         3.29         100%           -
original  ESP32-C3  stress_50pct       tired   3.67      747.0         3.28         100%           -
lim150    ESP32-C3  stress_50pct       tired   4.63        0.0         3.98          62%          39
dpm45ps   ESP32-C3  stress_50pct       tired   4.63        0.0         3.98          62%          39
bq100     ESP32-C3  stress_50pct       tired   4.69        0.0         3.94          13%          62
bq100lo   ESP32-C3  stress_50pct       tired   4.69        0.0         3.94          13%          62
bq500     ESP32-C3  stress_50pct       tired   4.54        0.0         4.15         100%          27
final     ESP32-C3  stress_50pct       tired   4.63        0.0         3.98          62%          39
final_lo  ESP32-C3  stress_50pct       tired   4.63        0.0         3.98          62%          39
final_hi  ESP32-C3  stress_50pct       tired   4.66        0.0         3.97          41%          46
original  ESP8266   traffic_2ms_20pct  weak    2.80      386.8         3.29         100%           -
original  ESP32-C3  traffic_2ms_20pct  weak    2.80      782.7         3.11         100%           -
lim150    ESP32-C3  traffic_2ms_20pct  weak    4.39     1625.7         3.99          99%          41
dpm45ps   ESP32-C3  traffic_2ms_20pct  weak    4.54        0.0         3.52           0%          81
bq100     ESP32-C3  traffic_2ms_20pct  weak    4.52        0.0         3.55           0%          71
bq100lo   ESP32-C3  traffic_2ms_20pct  weak    4.49     1999.3         3.95          34%          62
bq500     ESP32-C3  traffic_2ms_20pct  weak    4.51        0.0         3.55           0%          71
final     ESP32-C3  traffic_2ms_20pct  weak    4.52        0.0         3.55           0%          71
final_lo  ESP32-C3  traffic_2ms_20pct  weak    4.39     1678.5         3.99          99%          41
final_hi  ESP32-C3  traffic_2ms_20pct  weak    4.63        0.0         2.06           0%         257
original  ESP8266   worst_11b_12ms     weak    2.80      491.7         3.29         100%           -
original  ESP32-C3  worst_11b_12ms     weak    2.80      716.5         3.01         100%           -
lim150    ESP32-C3  worst_11b_12ms     weak    4.39     1129.6         3.97          57%          41
dpm45ps   ESP32-C3  worst_11b_12ms     weak    4.54        0.0         3.52           0%          81
bq100     ESP32-C3  worst_11b_12ms     weak    4.52        0.0         3.55           0%          71
bq100lo   ESP32-C3  worst_11b_12ms     weak    4.49     1976.0         3.93          33%          62
bq500     ESP32-C3  worst_11b_12ms     weak    4.51        0.0         3.55           0%          71
final     ESP32-C3  worst_11b_12ms     weak    4.52        0.0         3.55           0%          71
final_lo  ESP32-C3  worst_11b_12ms     weak    4.39     1123.0         3.97          56%          41
final_hi  ESP32-C3  worst_11b_12ms     weak    4.63        0.0         2.06           0%         257
original  ESP8266   stress_50pct       weak    2.80      808.5         3.29         100%           -
original  ESP32-C3  stress_50pct       weak    2.80     1555.8         3.11         100%           -
lim150    ESP32-C3  stress_50pct       weak    4.39     1999.7         3.98          55%          41
dpm45ps   ESP32-C3  stress_50pct       weak    4.54        0.0         3.52           0%          81
bq100     ESP32-C3  stress_50pct       weak    4.52        0.0         3.55           0%          71
bq100lo   ESP32-C3  stress_50pct       weak    4.49     1999.3         3.94          13%          62
bq500     ESP32-C3  stress_50pct       weak    4.51        0.0         3.55           0%          71
final     ESP32-C3  stress_50pct       weak    4.52        0.0         3.55           0%          71
final_lo  ESP32-C3  stress_50pct       weak    4.39     1999.7         3.98          55%          41
final_hi  ESP32-C3  stress_50pct       weak    4.63        0.0         2.06           0%         257
