hazy2go/wifi-game-boy-cartridge/sim/power/out/results.txt

design    chip      profile            cons   GBmin GB<4.5V ms rail/res min TX delivered radio up ms
original  ESP8266   traffic_2ms_20pct  fresh   4.23        2.5         3.29         100%           -
original  ESP32-C3  traffic_2ms_20pct  fresh   4.23        2.5         3.28         100%           -
lim150    ESP32-C3  traffic_2ms_20pct  fresh   4.78        0.0         3.99          99%          39
final     ESP32-C3  traffic_2ms_20pct  fresh   4.78        0.0         3.99          99%          39
final_lo  ESP32-C3  traffic_2ms_20pct  fresh   4.78        0.0         3.99          99%          39
c660      ESP32-C3  traffic_2ms_20pct  fresh   4.78        0.0         3.98          99%          18
c990      ESP32-C3  traffic_2ms_20pct  fresh   4.78        0.0         3.99          99%          27
c1320     ESP32-C3  traffic_2ms_20pct  fresh   4.78        0.0         3.99          99%          37
final_hi  ESP32-C3  traffic_2ms_20pct  fresh   4.78        0.0         3.99          99%          39
original  ESP8266   worst_11b_12ms     fresh   4.23        2.5         3.29         100%           -
original  ESP32-C3  worst_11b_12ms     fresh   4.23        2.5         3.28         100%           -
lim150    ESP32-C3  worst_11b_12ms     fresh   4.78        0.0         3.98          80%          39
final     ESP32-C3  worst_11b_12ms     fresh   4.78        0.0         3.98          79%          39
final_lo  ESP32-C3  worst_11b_12ms     fresh   4.78        0.0         3.98          79%          39
c660      ESP32-C3  worst_11b_12ms     fresh   4.78        0.0         3.98          54%          18
c990      ESP32-C3  worst_11b_12ms     fresh   4.78        0.0         3.98          65%          27
c1320     ESP32-C3  worst_11b_12ms     fresh   4.78        0.0         3.98          76%          37
final_hi  ESP32-C3  worst_11b_12ms     fresh   4.78        0.0         3.98          79%          39
original  ESP8266   stress_50pct       fresh   4.23        2.5         3.29         100%           -
original  ESP32-C3  stress_50pct       fresh   4.23        2.5         3.28         100%           -
lim150    ESP32-C3  stress_50pct       fresh   4.78        0.0         3.98          62%          39
final     ESP32-C3  stress_50pct       fresh   4.78        0.0         3.98          62%          39
final_lo  ESP32-C3  stress_50pct       fresh   4.78        0.0         3.98          62%          39
c660      ESP32-C3  stress_50pct       fresh   4.78        0.0         3.98          63%          18
c990      ESP32-C3  stress_50pct       fresh   4.78        0.0         3.98          62%          27
c1320     ESP32-C3  stress_50pct       fresh   4.78        0.0         3.98          62%          37
final_hi  ESP32-C3  stress_50pct       fresh   4.78        0.0         3.98          62%          39
original  ESP8266   traffic_2ms_20pct  tired   3.67        3.1         3.29         100%           -
original  ESP32-C3  traffic_2ms_20pct  tired   3.67      353.2         3.28         100%           -
lim150    ESP32-C3  traffic_2ms_20pct  tired   4.63        0.0         3.99          99%          39
final     ESP32-C3  traffic_2ms_20pct  tired   4.63        0.0         3.99          99%          39
final_lo  ESP32-C3  traffic_2ms_20pct  tired   4.63        0.0         3.99          99%          39
c660      ESP32-C3  traffic_2ms_20pct  tired   4.63        0.0         3.98          99%          18
c990      ESP32-C3  traffic_2ms_20pct  tired   4.63        0.0         3.99          99%          27
c1320     ESP32-C3  traffic_2ms_20pct  tired   4.63        0.0         3.99          99%          37
final_hi  ESP32-C3  traffic_2ms_20pct  tired   4.66        0.0         3.98          98%          46
original  ESP8266   worst_11b_12ms     tired   3.67        3.1         3.29         100%           -
original  ESP32-C3  worst_11b_12ms     tired   3.67      473.0         3.28         100%           -
lim150    ESP32-C3  worst_11b_12ms     tired   4.63        0.0         3.98          72%          39
final     ESP32-C3  worst_11b_12ms     tired   4.63        0.0         3.98          71%          39
final_lo  ESP32-C3  worst_11b_12ms     tired   4.63        0.0         3.98          71%          39
c660      ESP32-C3  worst_11b_12ms     tired   4.63        0.0         3.98          50%          18
c990      ESP32-C3  worst_11b_12ms     tired   4.63        0.0         3.98          59%          27
c1320     ESP32-C3  worst_11b_12ms     tired   4.63        0.0         3.98          68%          37
final_hi  ESP32-C3  worst_11b_12ms     tired   4.66        0.0         3.97          61%          46
original  ESP8266   stress_50pct       tired   3.67        3.1         3.29         100%           -
original  ESP32-C3  stress_50pct       tired   3.67      747.0         3.28         100%           -
lim150    ESP32-C3  stress_50pct       tired   4.63        0.0         3.98          62%          39
final     ESP32-C3  stress_50pct       tired   4.63        0.0         3.98          62%          39
final_lo  ESP32-C3  stress_50pct       tired   4.63        0.0         3.98          62%          39
c660      ESP32-C3  stress_50pct       tired   4.63        0.0         3.98          63%          18
c990      ESP32-C3  stress_50pct       tired   4.63        0.0         3.98          62%          27
c1320     ESP32-C3  stress_50pct       tired   4.63        0.0         3.98          62%          37
final_hi  ESP32-C3  stress_50pct       tired   4.66        0.0         3.97          41%          46
original  ESP8266   traffic_2ms_20pct  weak    2.80      386.8         3.29         100%           -
original  ESP32-C3  traffic_2ms_20pct  weak    2.80      782.7         3.11         100%           -
lim150    ESP32-C3  traffic_2ms_20pct  weak    4.39     1625.7         3.99          99%          41
final     ESP32-C3  traffic_2ms_20pct  weak    4.52        0.0         4.19           6%          71
final_lo  ESP32-C3  traffic_2ms_20pct  weak    4.46       57.0         4.22           6%          52
c660      ESP32-C3  traffic_2ms_20pct  weak    4.52        0.0         4.25           3%          33
c990      ESP32-C3  traffic_2ms_20pct  weak    4.52        0.0         4.22           5%          50
c1320     ESP32-C3  traffic_2ms_20pct  weak    4.52        0.0         4.20           6%          67
final_hi  ESP32-C3  traffic_2ms_20pct  weak    4.63        0.0         2.06           0%         257
original  ESP8266   worst_11b_12ms     weak    2.80      491.7         3.29         100%           -
original  ESP32-C3  worst_11b_12ms     weak    2.80      716.5         3.01         100%           -
lim150    ESP32-C3  worst_11b_12ms     weak    4.39     1129.6         3.97          57%          41
final     ESP32-C3  worst_11b_12ms     weak    4.52        0.0         4.19           1%          71
final_lo  ESP32-C3  worst_11b_12ms     weak    4.46       57.0         4.22           1%          52
c660      ESP32-C3  worst_11b_12ms     weak    4.52        0.0         4.25           1%          33
c990      ESP32-C3  worst_11b_12ms     weak    4.52        0.0         4.22           1%          50
c1320     ESP32-C3  worst_11b_12ms     weak    4.52        0.0         4.20           1%          67
final_hi  ESP32-C3  worst_11b_12ms     weak    4.63        0.0         2.06           0%         257
original  ESP8266   stress_50pct       weak    2.80      808.5         3.29         100%           -
original  ESP32-C3  stress_50pct       weak    2.80     1555.8         3.11         100%           -
lim150    ESP32-C3  stress_50pct       weak    4.39     1999.7         3.98          55%          41
final     ESP32-C3  stress_50pct       weak    4.52        0.0         4.19           6%          71
final_lo  ESP32-C3  stress_50pct       weak    4.46       57.0         4.22           6%          52
c660      ESP32-C3  stress_50pct       weak    4.52        0.0         4.25           3%          33
c990      ESP32-C3  stress_50pct       weak    4.52        0.0         4.22           4%          50
c1320     ESP32-C3  stress_50pct       weak    4.52        0.0         4.20           5%          67
final_hi  ESP32-C3  stress_50pct       weak    4.63        0.0         2.06           0%         257
