hazy2go/wifi-game-boy-cartridge/hw/rev-b/GameboyCartridgeV2.1-RevB-schematic.pdf

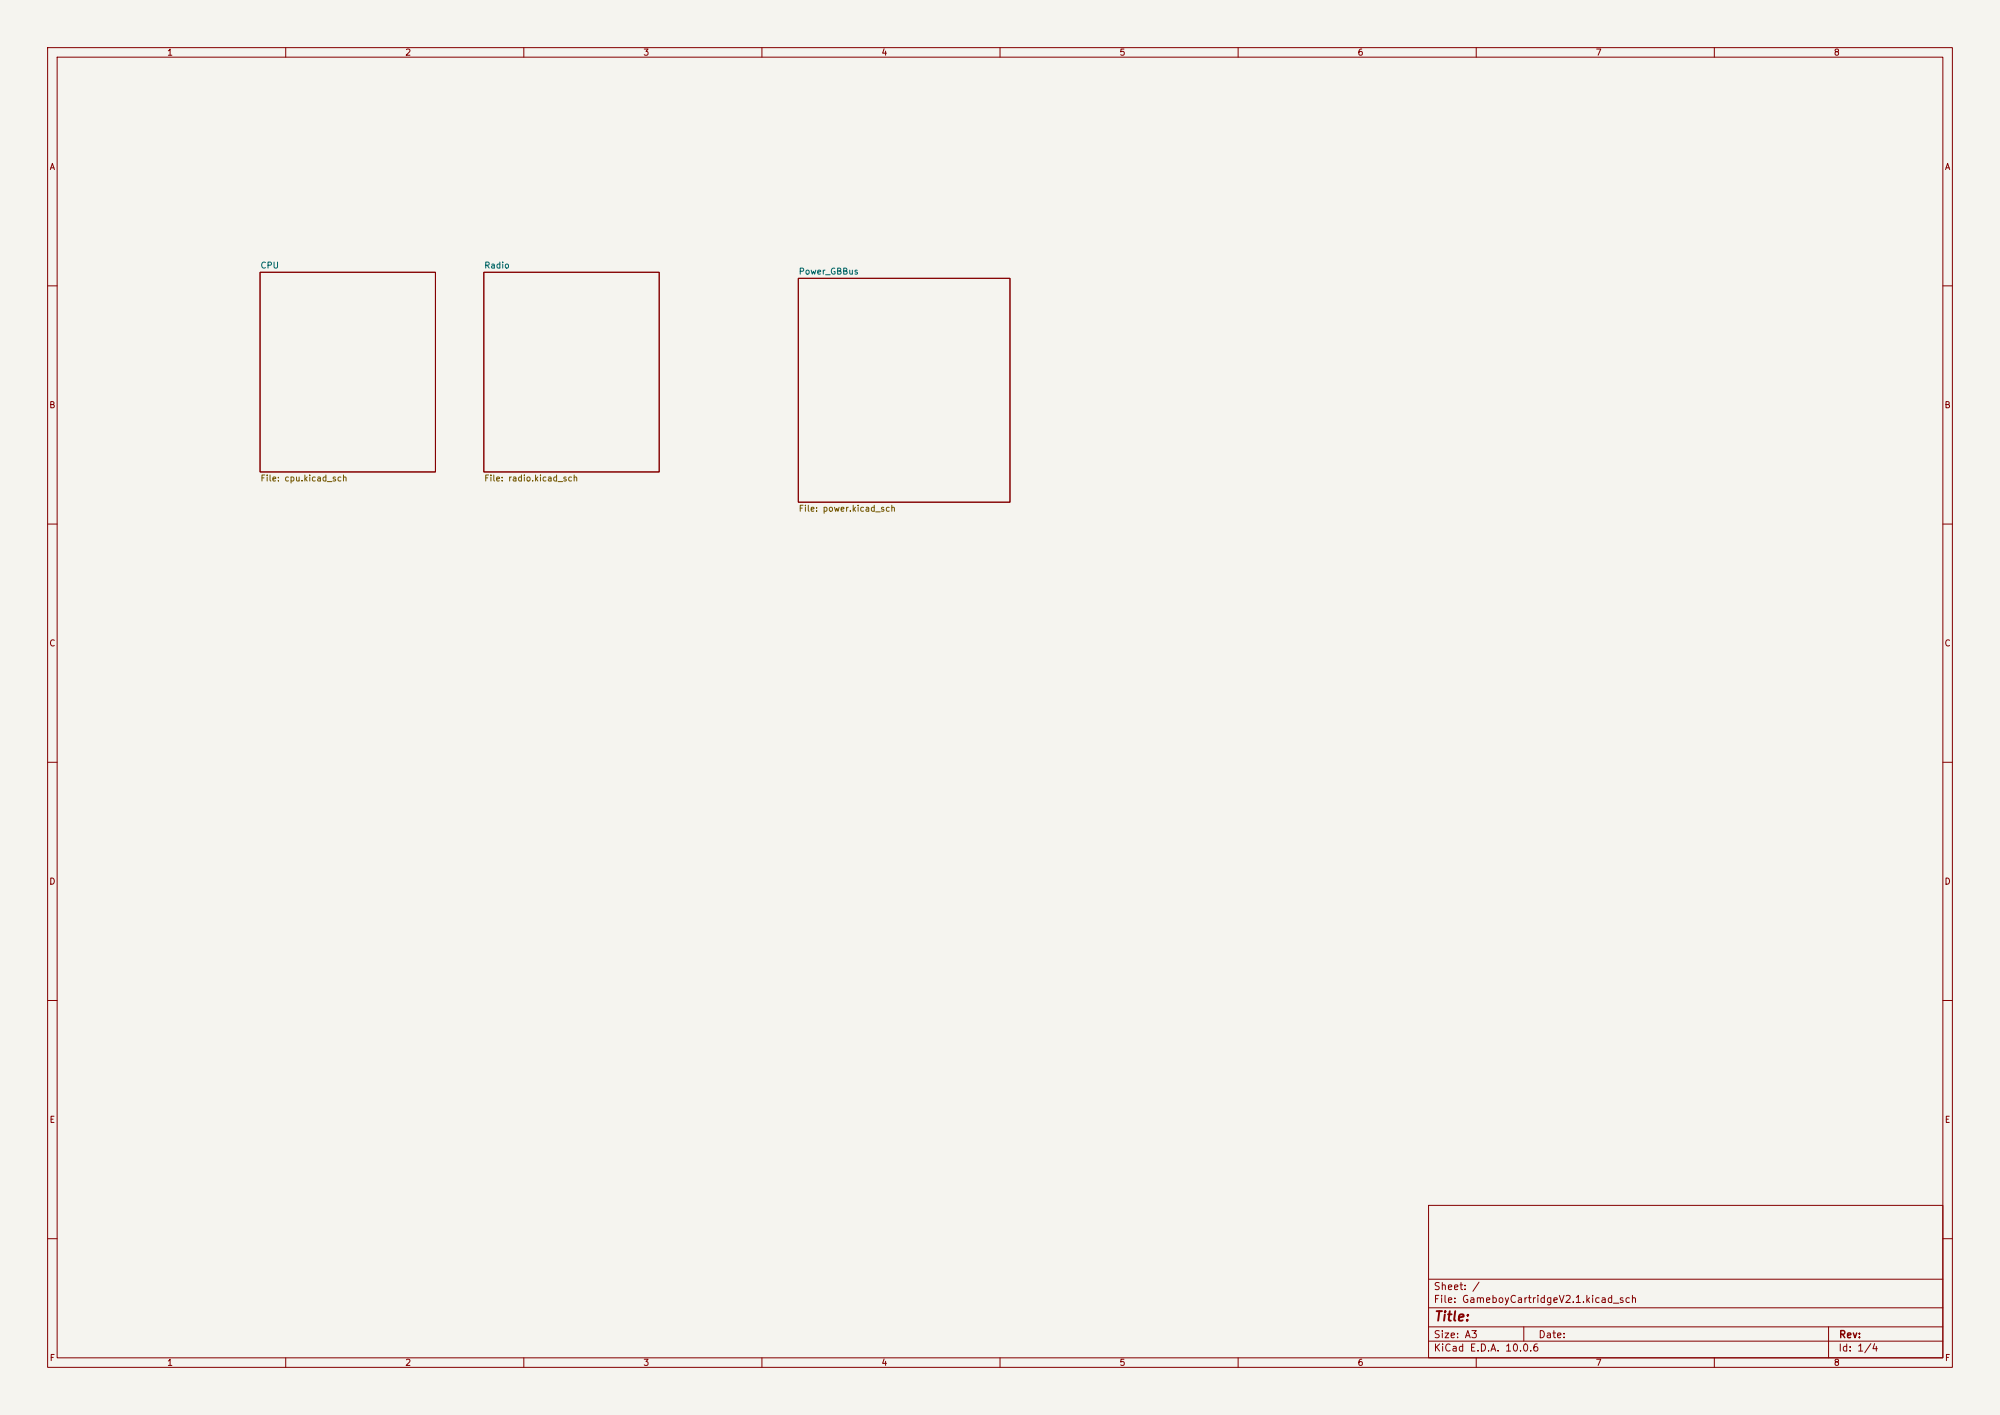
[picture p37: page 1]

Size: A3 | Rev: | F Date:
KiCad E.D.A. 10.0.6 | Id: 1/4

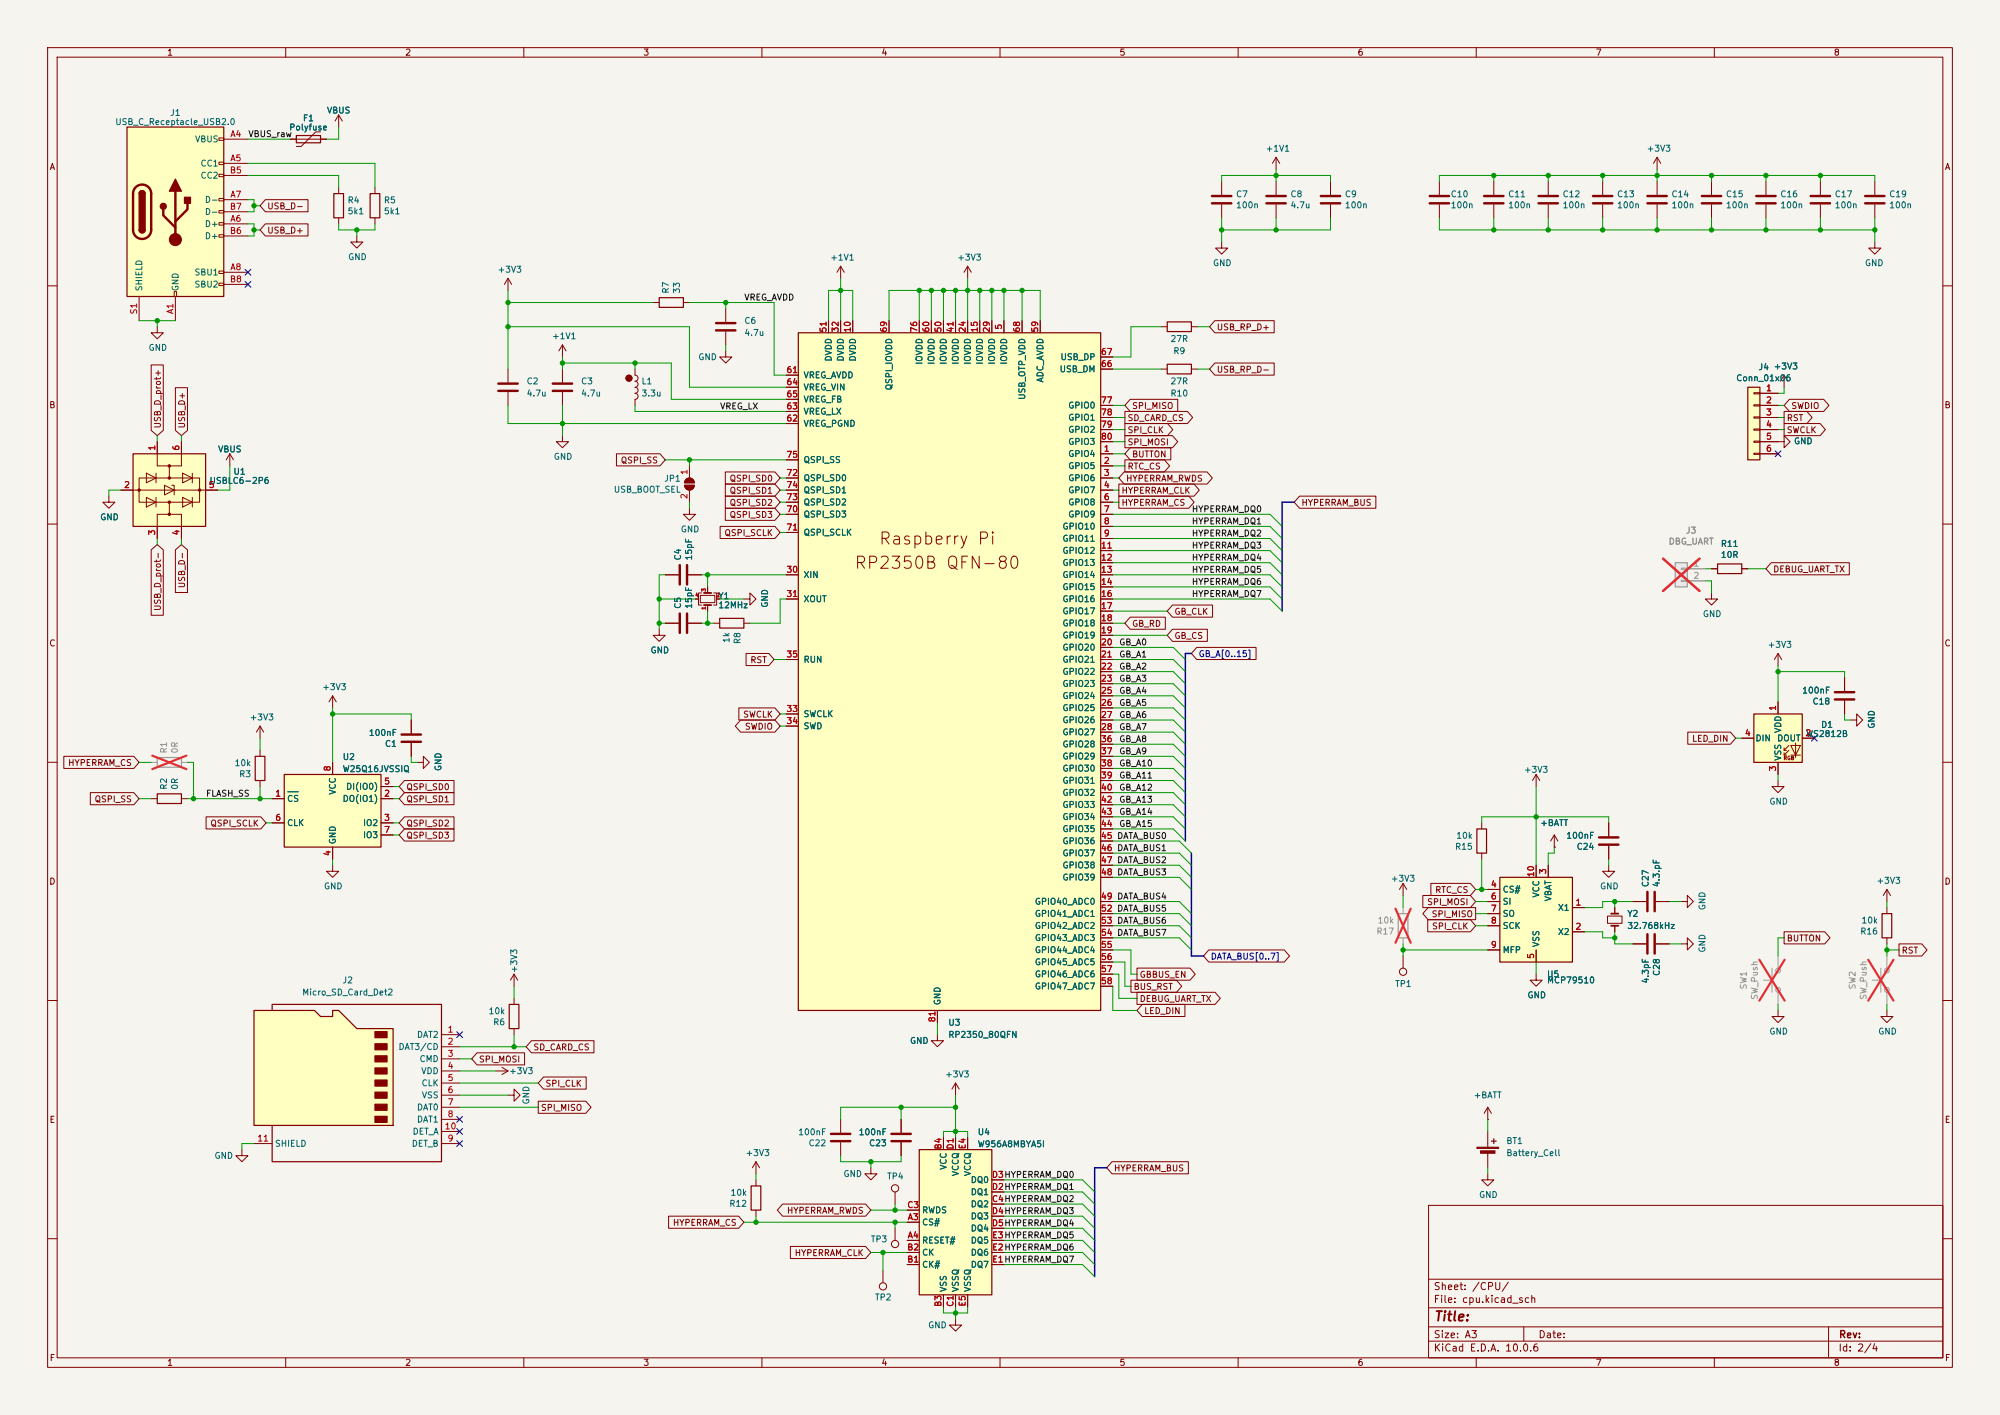
[picture p38: page 2]

5 GPIO8 6 GPIO9 7 GPIO10 8 GPIO11 9 DVDD 10 GPIO12 11 GPIO13 12 GPIO14 13 GPIO15 14 IOVDD 15 GPIO16 16 GPIO17 17 GPIO18 18 GPIO19 19 GPIO20 20 GPIO21 21 GPIO22 22 GPIO23 23 IOVDD 24 GPIO24 25 GPIO25 26 GPIO26 27 GPIO27 28 IOVDD 29

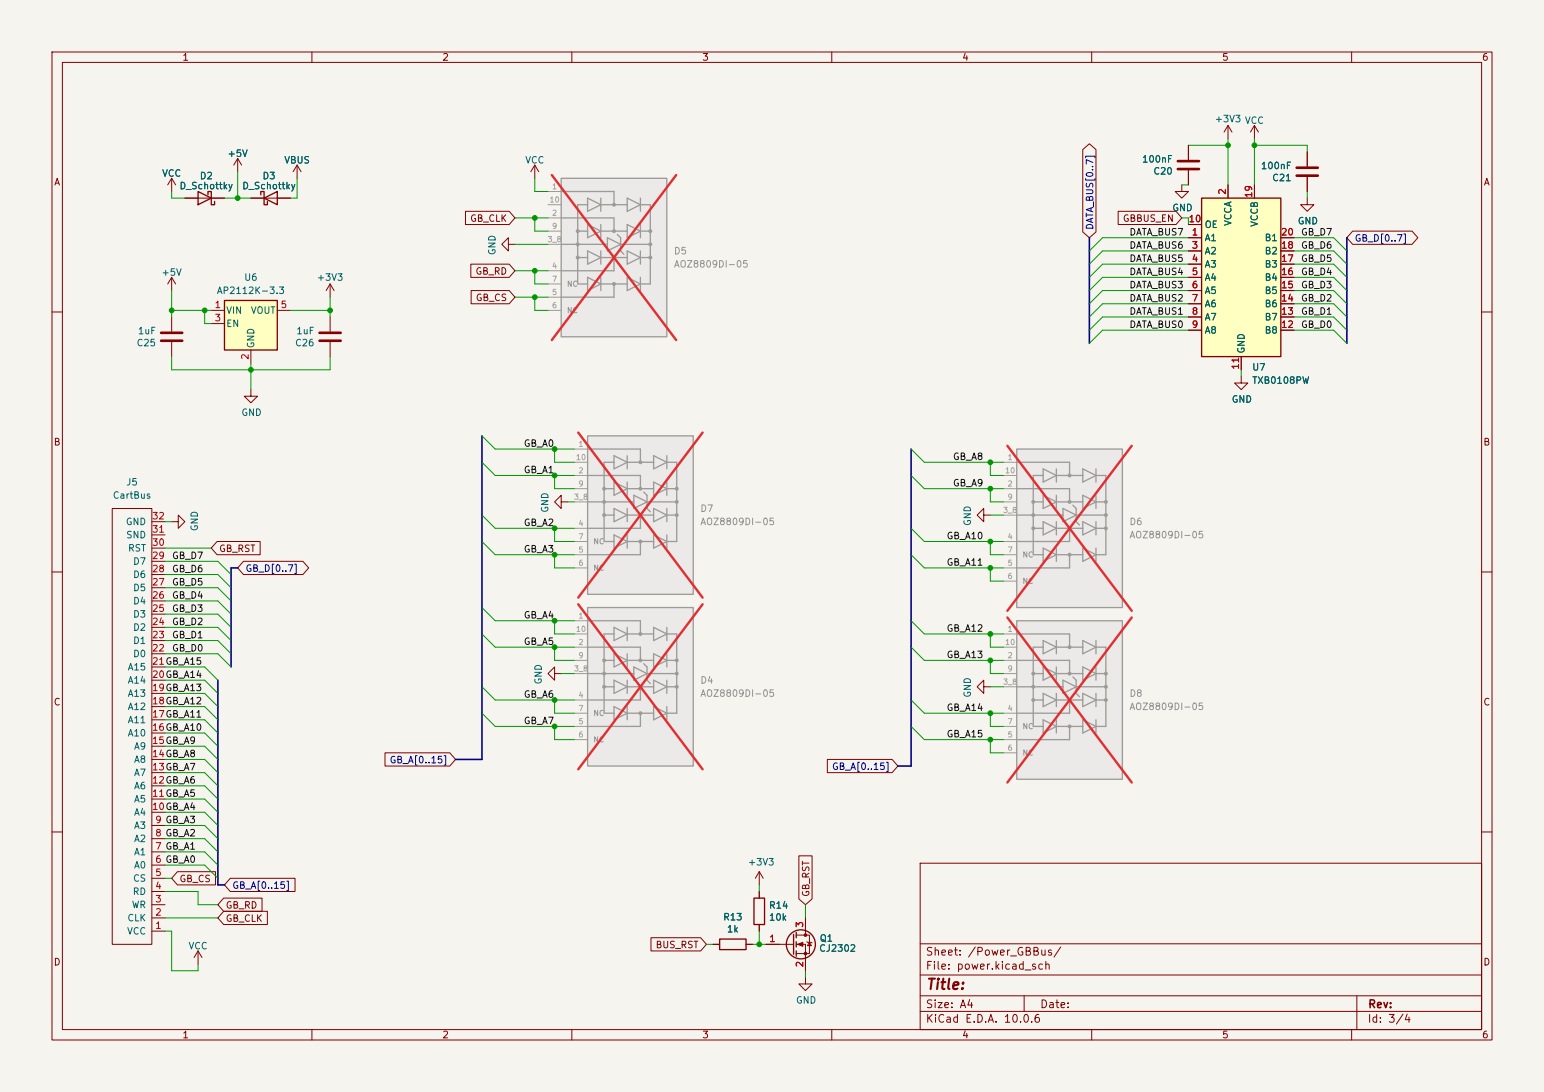
[picture p39: page 3]

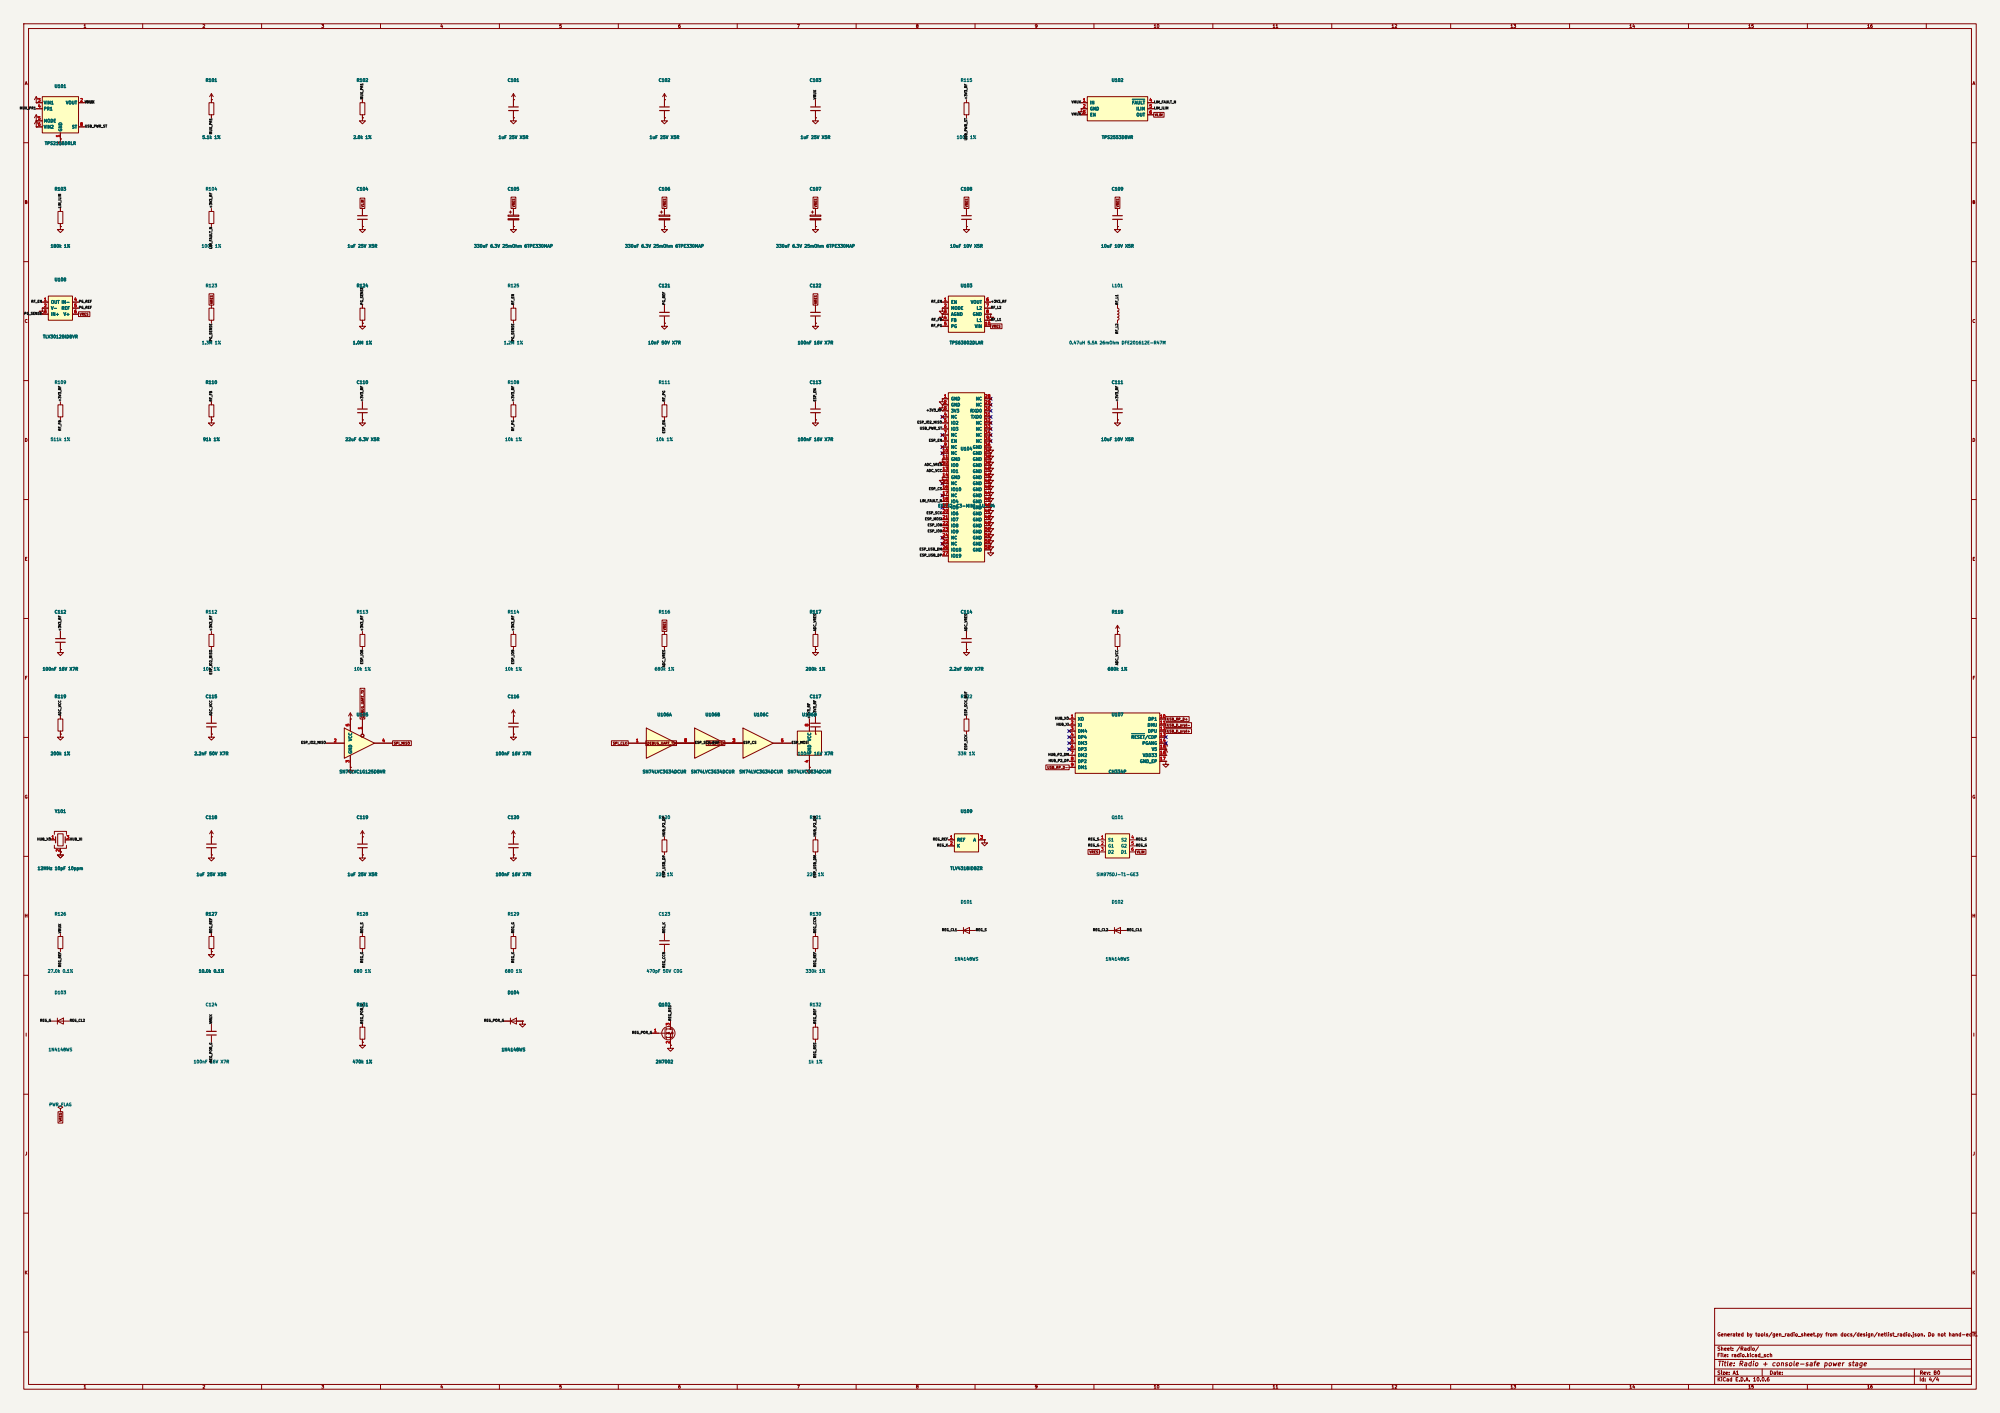
[picture p40: page 4]

Generated by tools/gen_radio_sheet.py from docs/design/netlist_radio.json. Do not hand-edit.

Sheet: /Radio/
File: radio.kicad_sch
Title: Radio + console-safe power stage
