hazy2go/wifi-game-boy-cartridge/hw/rev-b/GameboyCartridgeV2.1Schematics.pdf

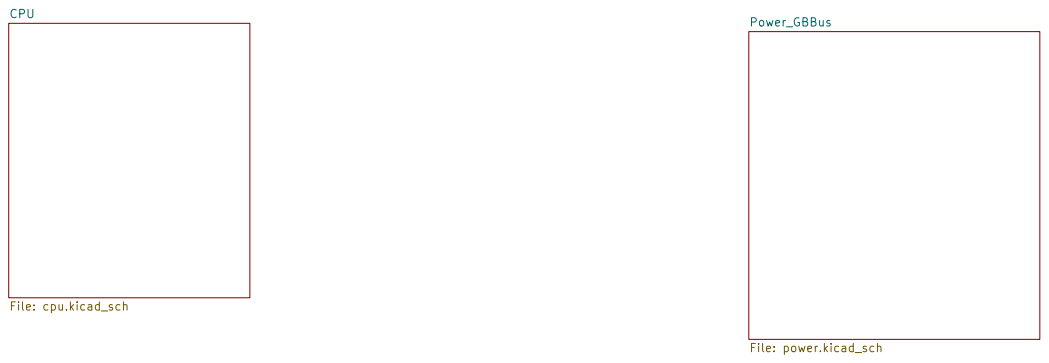
[picture p41: page 1]

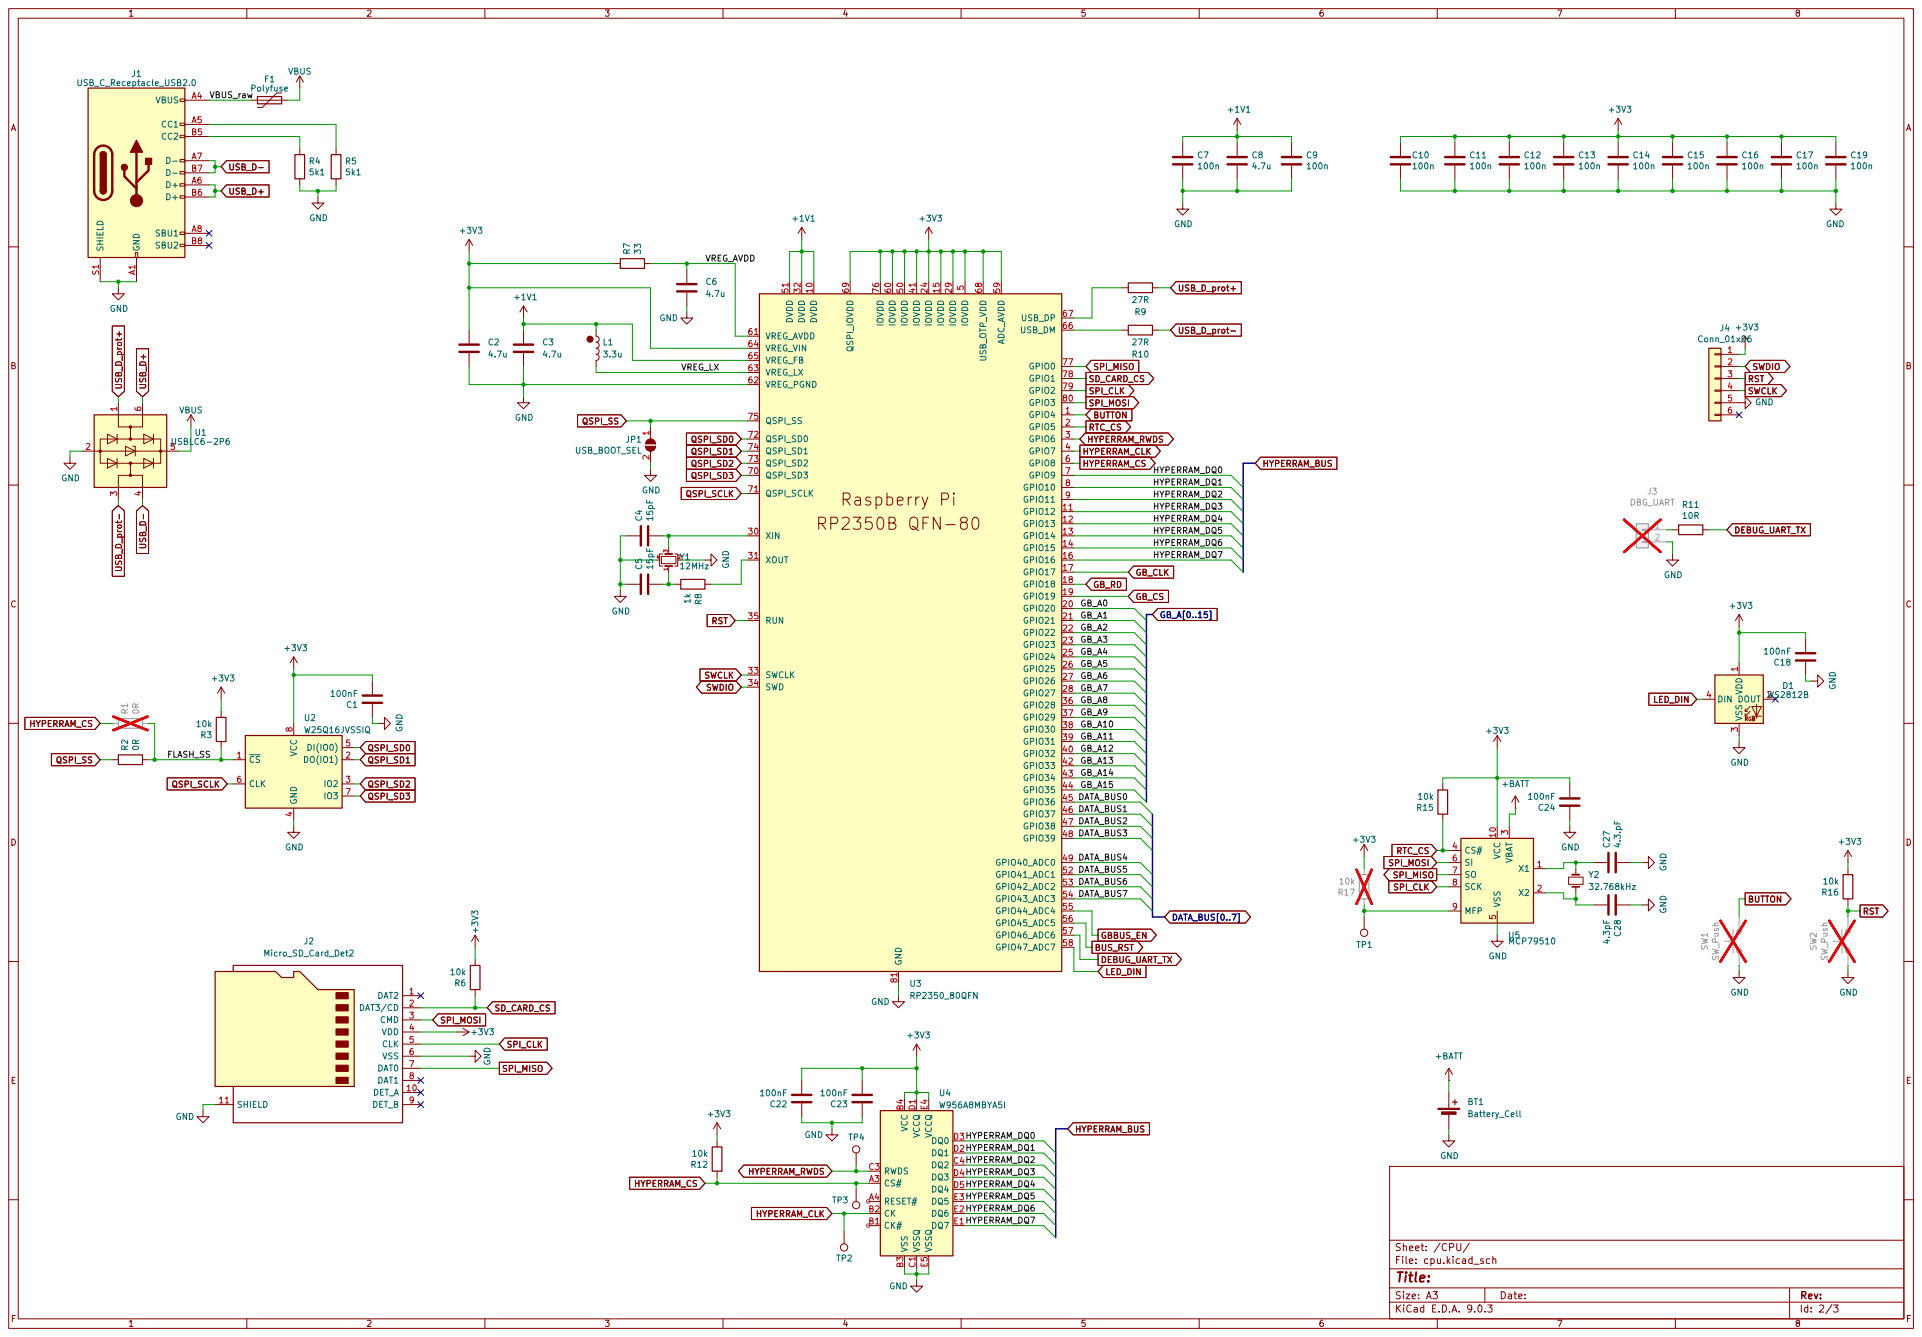
[picture p42: page 2]

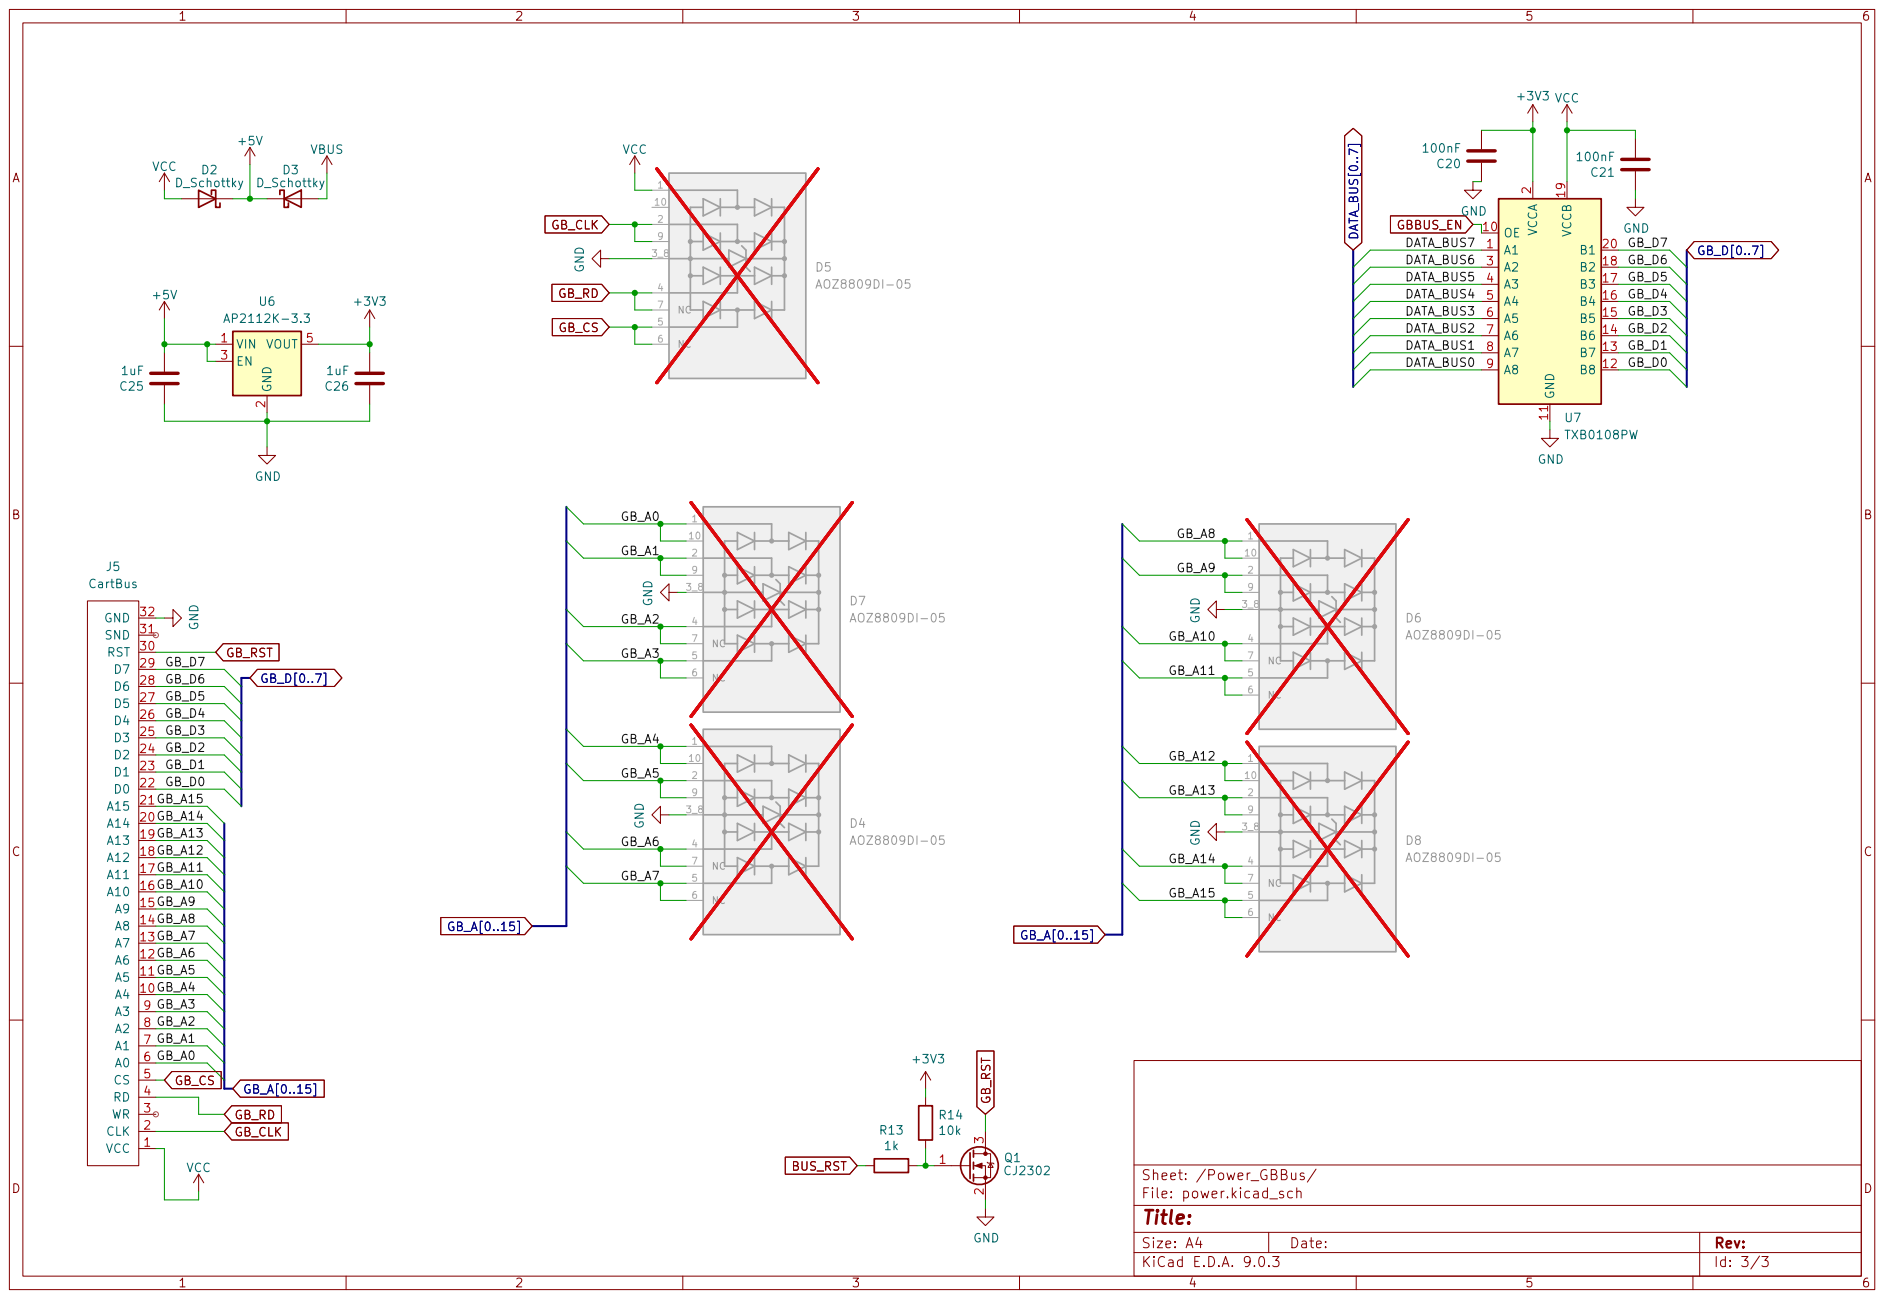
[picture p43: page 3]
