hazy2go/wifi-game-boy-cartridge/sim/power/out/new_ESP32-C3_traffic_2ms_20pct_fresh_c1320.cir

* proposed design ESP32-C3 traffic_2ms_20pct fresh ilim=0.15 vdpm=4.5
Vgb src 0 5.0
Rsrc src gb 0.7
Cgb gb 0 0.0001
Igb gb 0 0.1
* Croco logic side (RP2350 + HyperRAM + flash + level shifter), steady (assumption 60 mA)
Ilogic gb 0 0.060
* Supervisor gating the switch (APX803-44 4.38V, or precision TLV431 comparator for the final design), smooth step for convergence
Bsup en 0 V = 0.5*(1+tanh((V(gb)-4.45)/0.01))
Ren en 0 1meg
* current-limited switch: 85 mOhm, constant-current limit, no reverse current, optional DPM foldback
Bsw gb res I = V(en) * max(0, min(max(0, min(0.15, 5*(V(gb)-4.5))), (V(gb)-V(res))/0.285))
Cres res cresn 0.00132
Resr cresn 0 0.00625
Rbleed res 0 100k
* radio power-good with hysteresis (on at 4.2V, off at 2.0V)
Bpgx pgx 0 V = 0.5*(1+tanh((V(res)-(4.2-2.2*V(pg)))/0.02))
Rpg pgx pg 1k
Cpg pg 0 100n
* firmware throttle: TX bursts skipped while reservoir < V_THROTTLE; modem-sleep below V_PSAVE
Bthr thr 0 V = 0.5*(1+tanh((V(res)-4.0)/0.05)) * 0.5*(1+tanh((V(gb)-4.55)/0.01))
Bps ps 0 V = 0.5*(1+tanh((V(res)-3.5)/0.05)) * 0.5*(1+tanh((V(gb)-4.55)/0.01))
Rps ps 0 1meg
Rthr thr 0 1meg
* radio current (1 V = 1 A): RX baseline + throttled TX bursts, only when power-good
Viprof iprof 0 PWL(0.000000 0.0000 0.020000 0.0000 0.020001 0.0840 0.021000 0.0840 0.021005 0.3350 0.022000 0.3350 0.022005 0.0840 0.023000 0.0840 0.023005 0.3350 0.024000 0.3350 0.024005 0.0840 0.025000 0.0840 0.025005 0.3350 0.026000 0.3350 0.026005 0.0840 0.027000 0.0840 0.027005 0.3350 0.028000 0.3350 0.028005 0.0840 0.029000 0.0840 0.029005 0.3350 0.030000 0.3350 0.030005 0.0840 0.031000 0.0840 0.031005 0.3350 0.032000 0.3350 0.032005 0.0840 0.033000 0.0840 0.033005 0.3350 0.034000 0.3350 0.034005 0.0840 0.035000 0.0840 0.035005 0.3350 0.036000 0.3350 0.036005 0.0840 0.037000 0.0840 0.037005 0.3350 0.038000 0.3350 0.038005 0.0840 0.039000 0.0840 0.039005 0.3350 0.040000 0.3350 0.040005 0.0840 0.041000 0.0840 0.041005 0.3350 0.042000 0.3350 0.042005 0.0840 0.043000 0.0840 0.043005 0.3350 0.044000 0.3350 0.044005 0.0840 0.045000 0.0840 0.045005 0.3350 0.046000 0.3350 0.046005 0.0840 0.047000 0.0840 0.047005 0.3350 0.048000 0.3350 0.048005 0.0840 0.049000 0.0840 0.049005 0.3350 0.050000 0.3350 0.050005 0.0840 0.051000 0.0840 0.051005 0.3350 0.052000 0.3350 0.052005 0.0840 0.053000 0.0840 0.053005 0.3350 0.054000 0.3350 0.054005 0.0840 0.055000 0.0840 0.055005 0.3350 0.056000 0.3350 0.056005 0.0840 0.057000 0.0840 0.057005 0.3350 0.058000 0.3350 0.058005 0.0840 0.059000 0.0840 0.059005 0.3350 0.060000 0.3350 0.060005 0.0840 0.061000 0.0840 0.061005 0.3350 0.062000 0.3350 0.062005 0.0840 0.063000 0.0840 0.063005 0.3350 0.064000 0.3350 0.064005 0.0840 0.065000 0.0840 0.065005 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
.ic v(gb)=4.93 v(res)=0 v(pg)=0
.options method=gear reltol=1e-3
.tran 20u 2.0 0 20u uic
.control
run
wrdata /Users/hazymacmini/Projects/wifi-game-boy-cartridge/sim/power/out/new_ESP32-C3_traffic_2ms_20pct_fresh_c1320.dat v(gb) v(res) v(pg) v(thr) v(iprof) v(iload)
quit
.endc
.end
