hazy2go/wifi-game-boy-cartridge/hw/rev-b/GameboyCartridgeV2.1.kicad_pcb

## KiCad design hw/rev-b/GameboyCartridgeV2.1.kicad_pcb (continued)

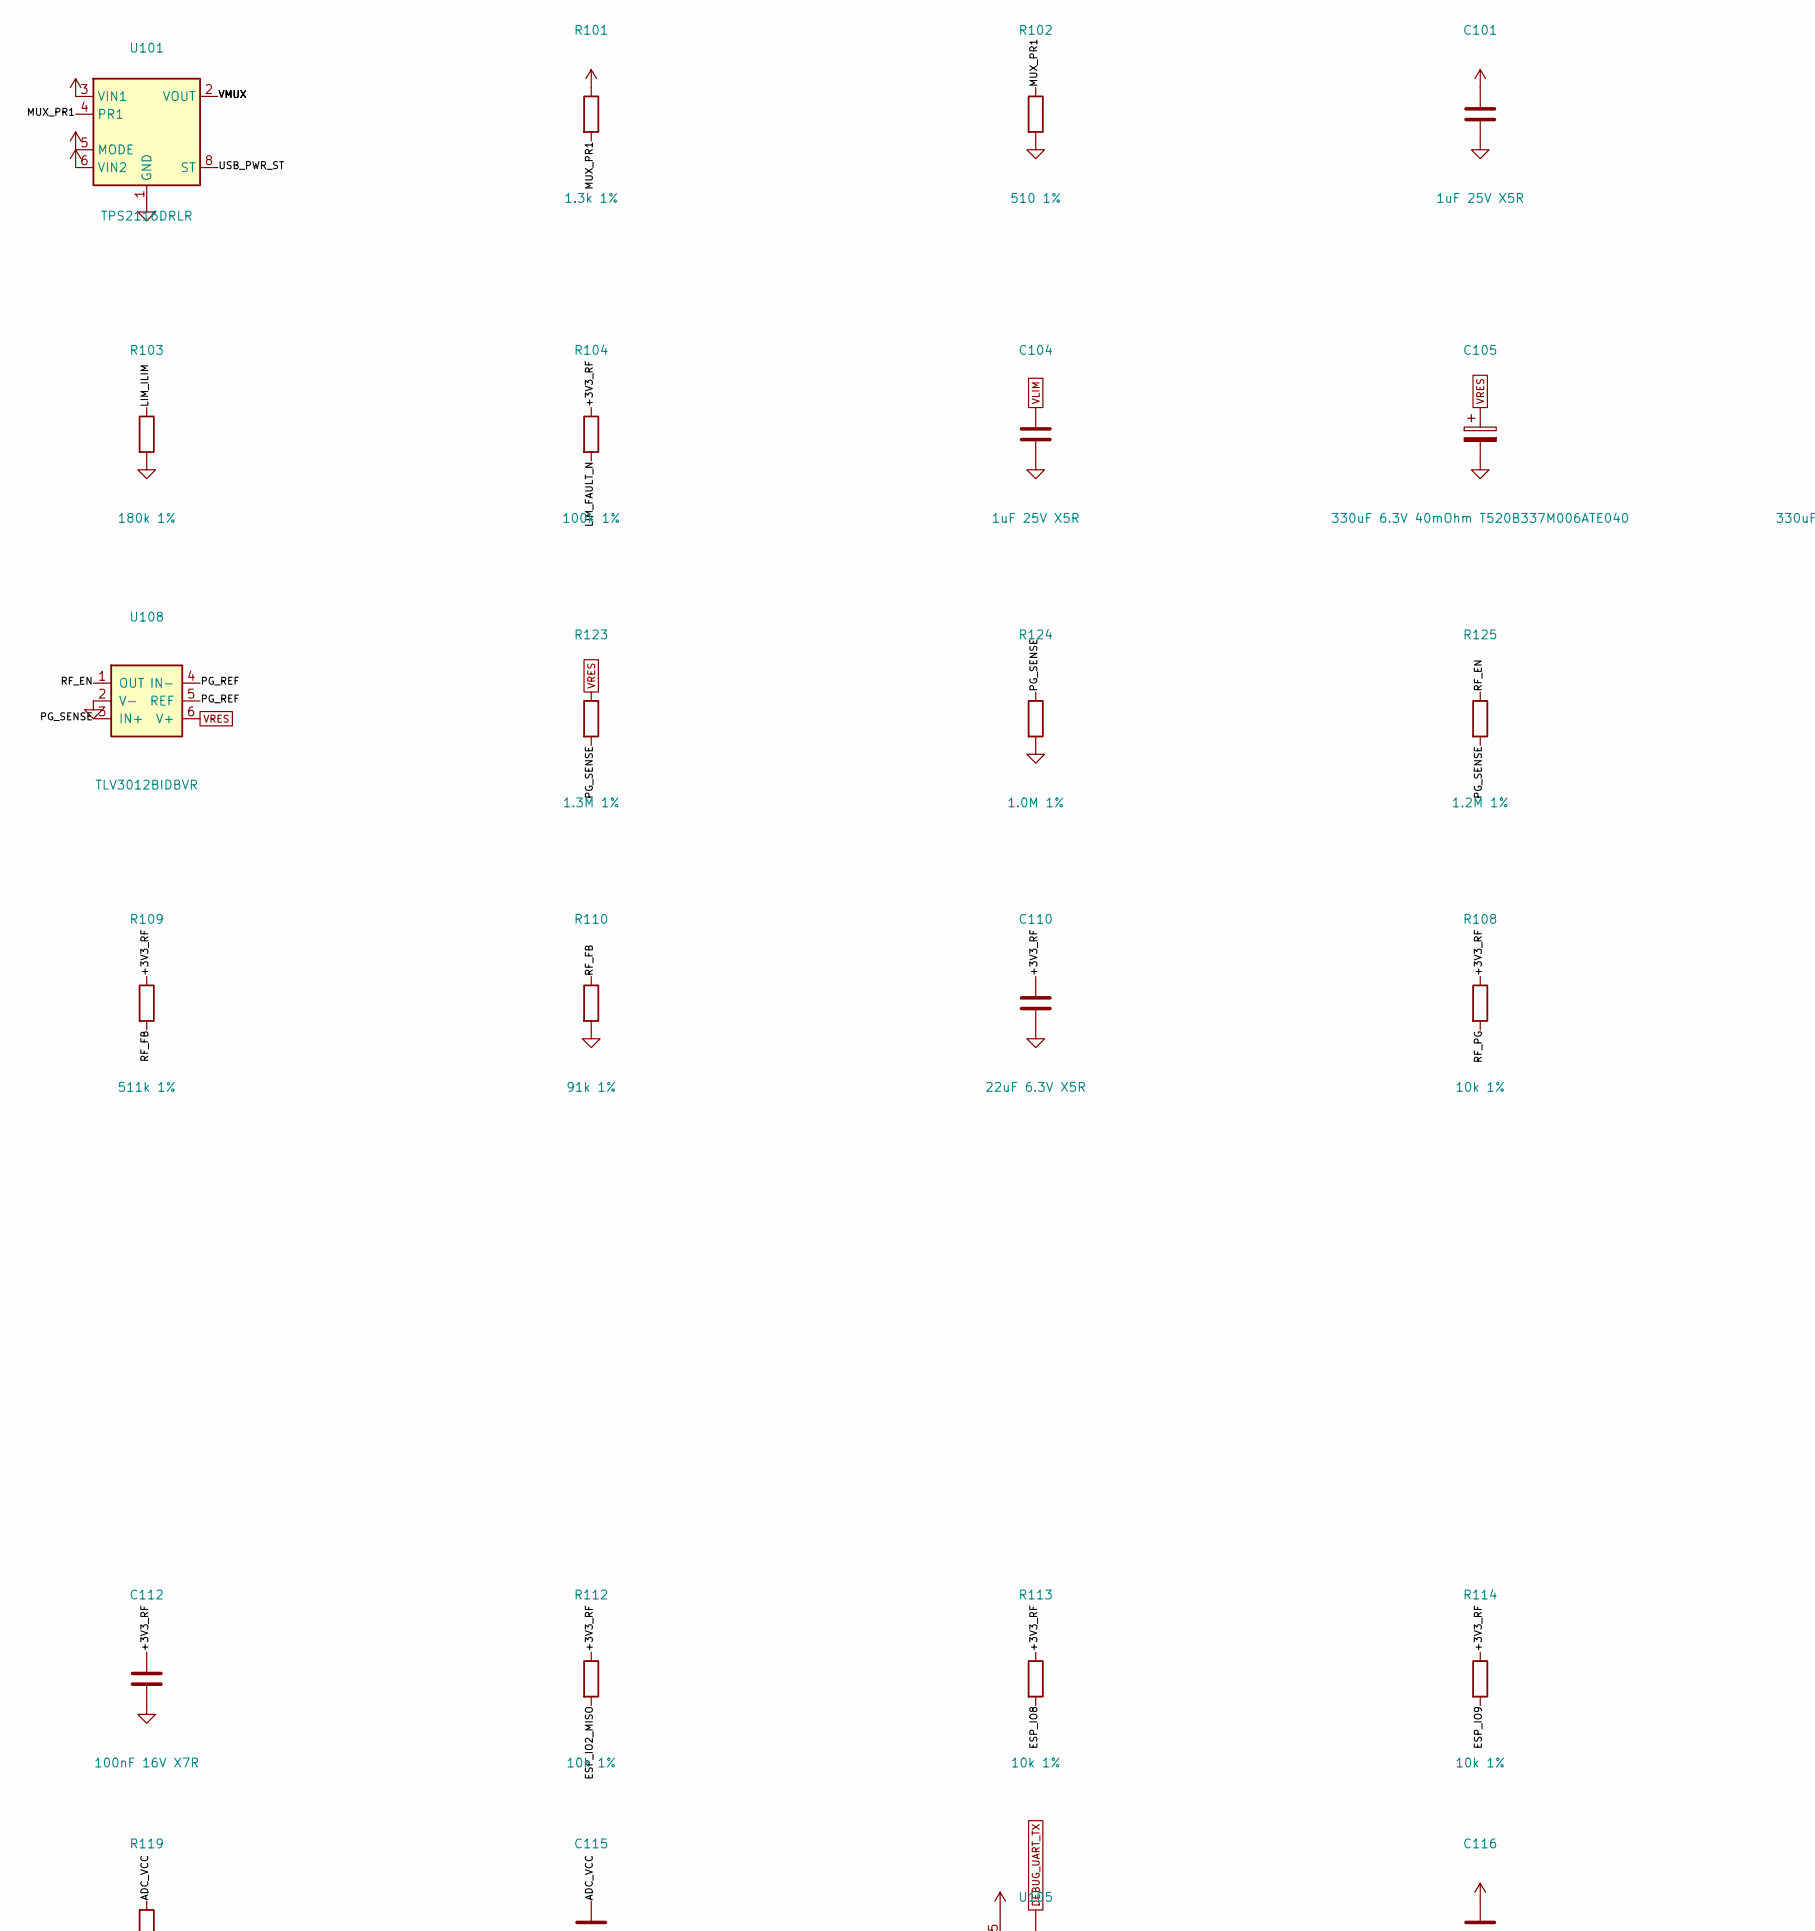
[picture p46: schematic radio.kicad_sch, Radio + console-safe power stage, part in row 1, column 1]

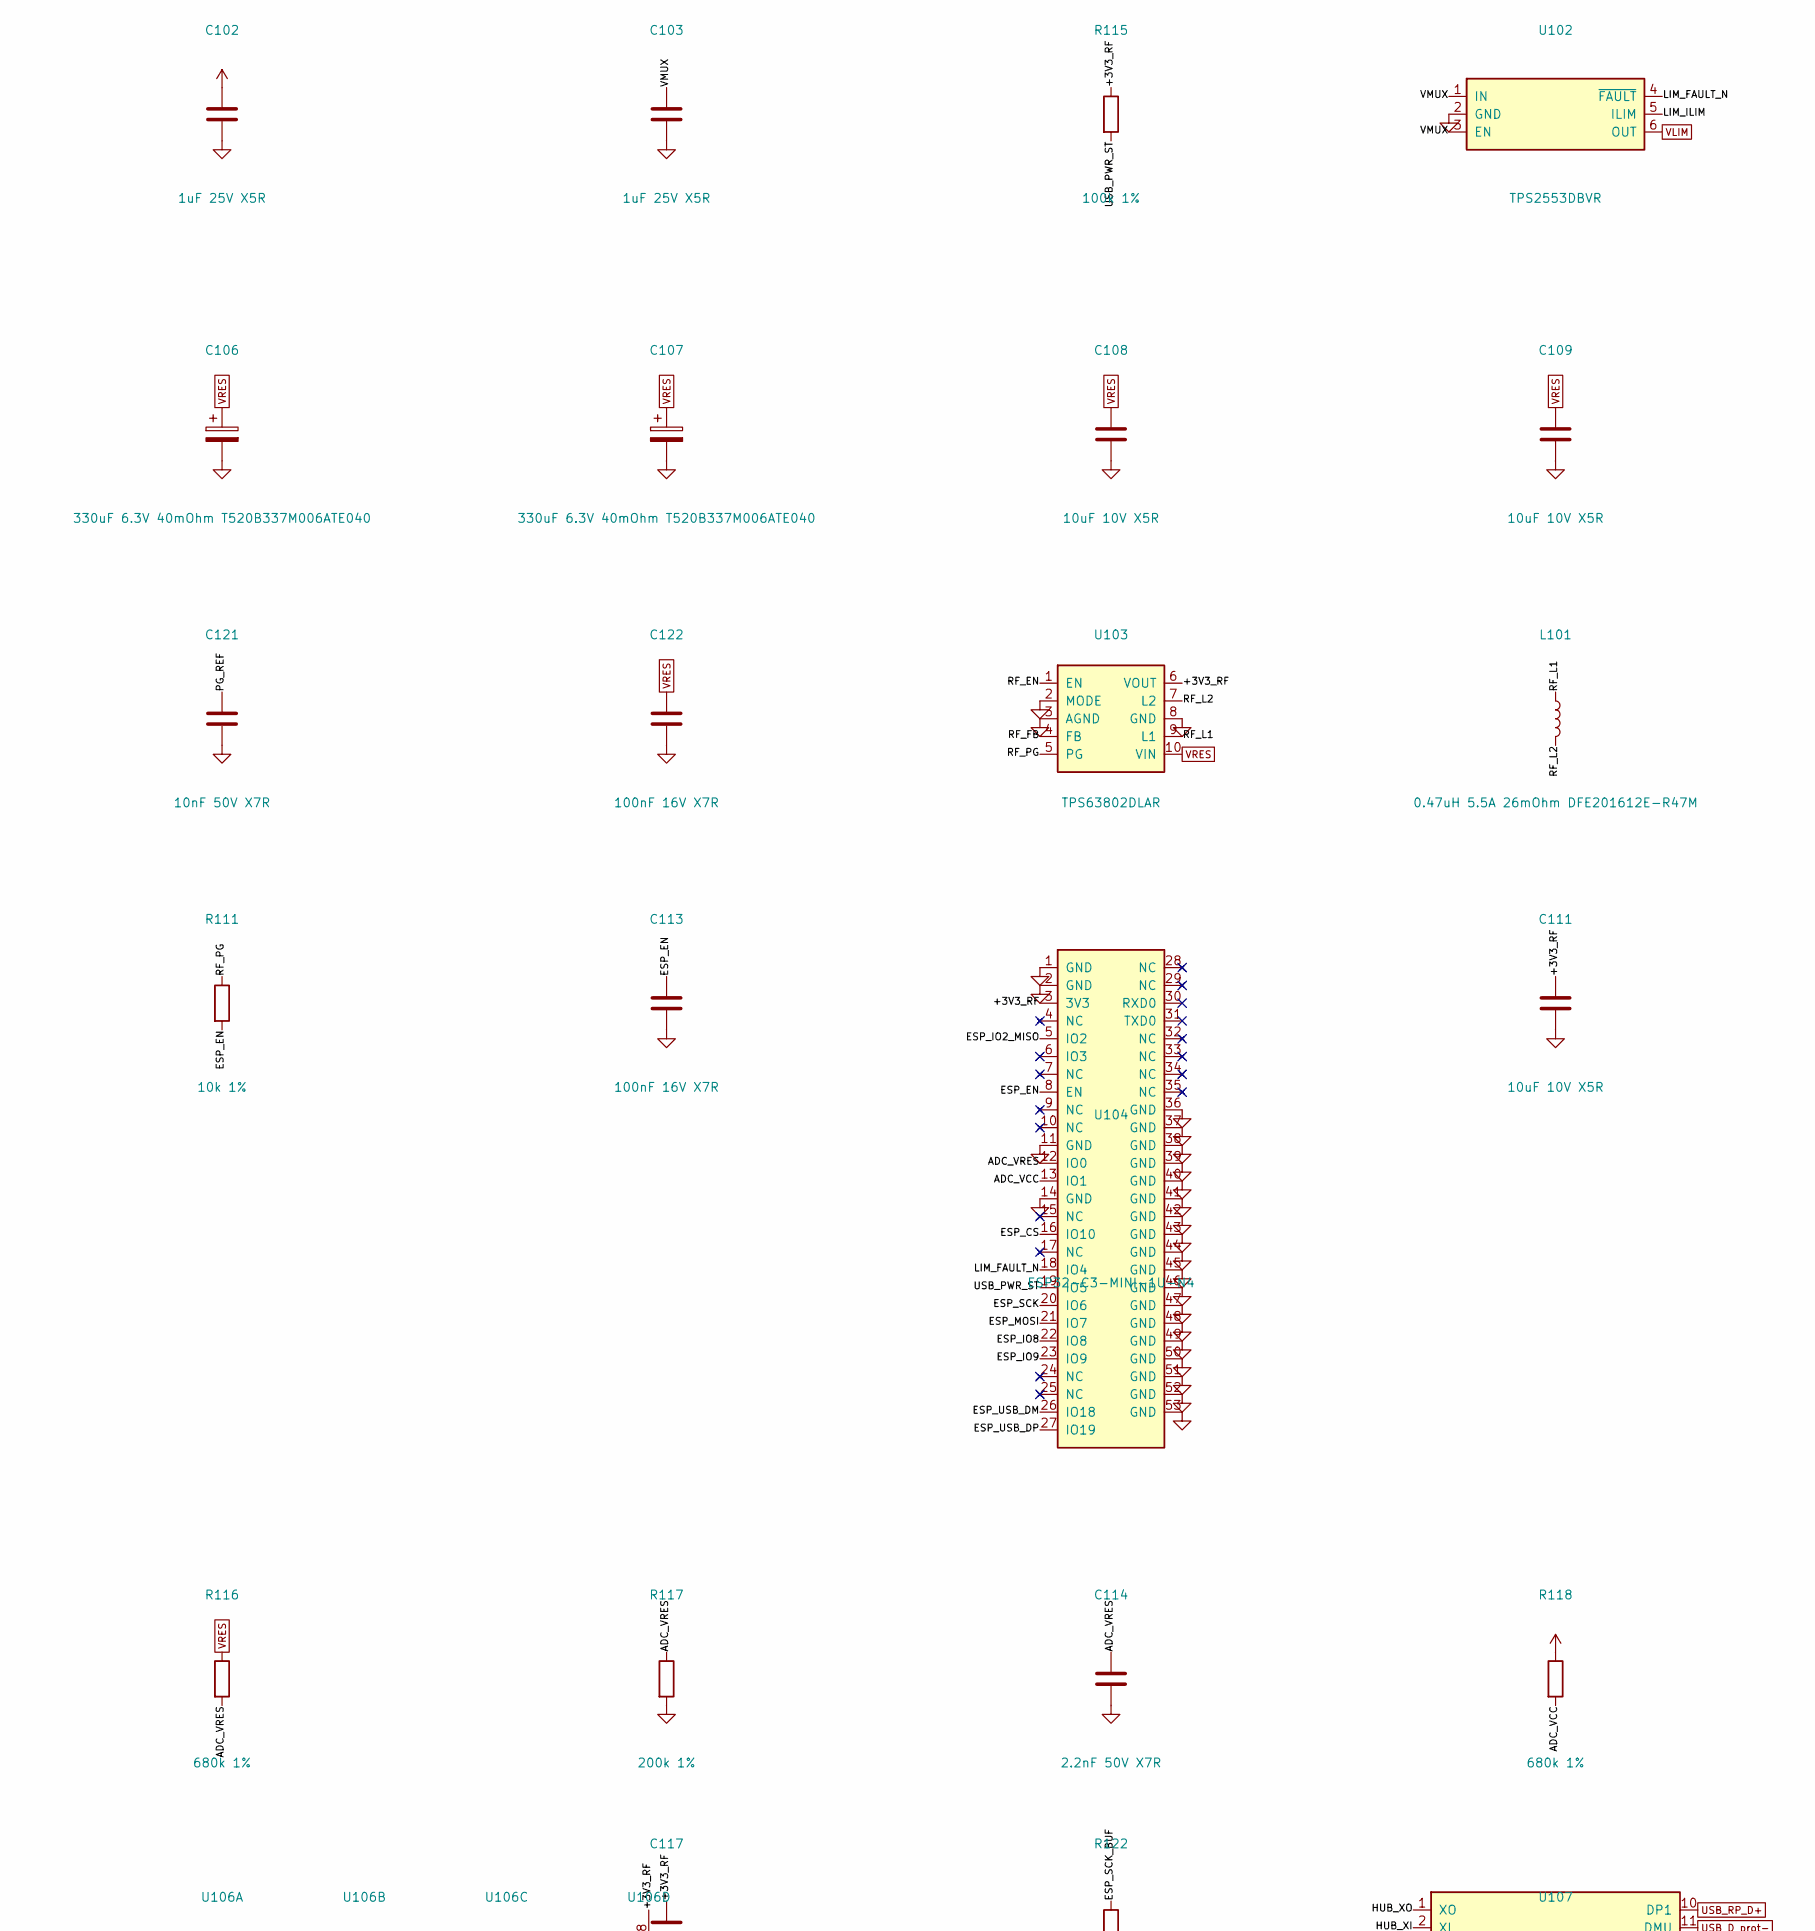
[picture p47: schematic radio.kicad_sch, Radio + console-safe power stage, part in row 1, column 2]

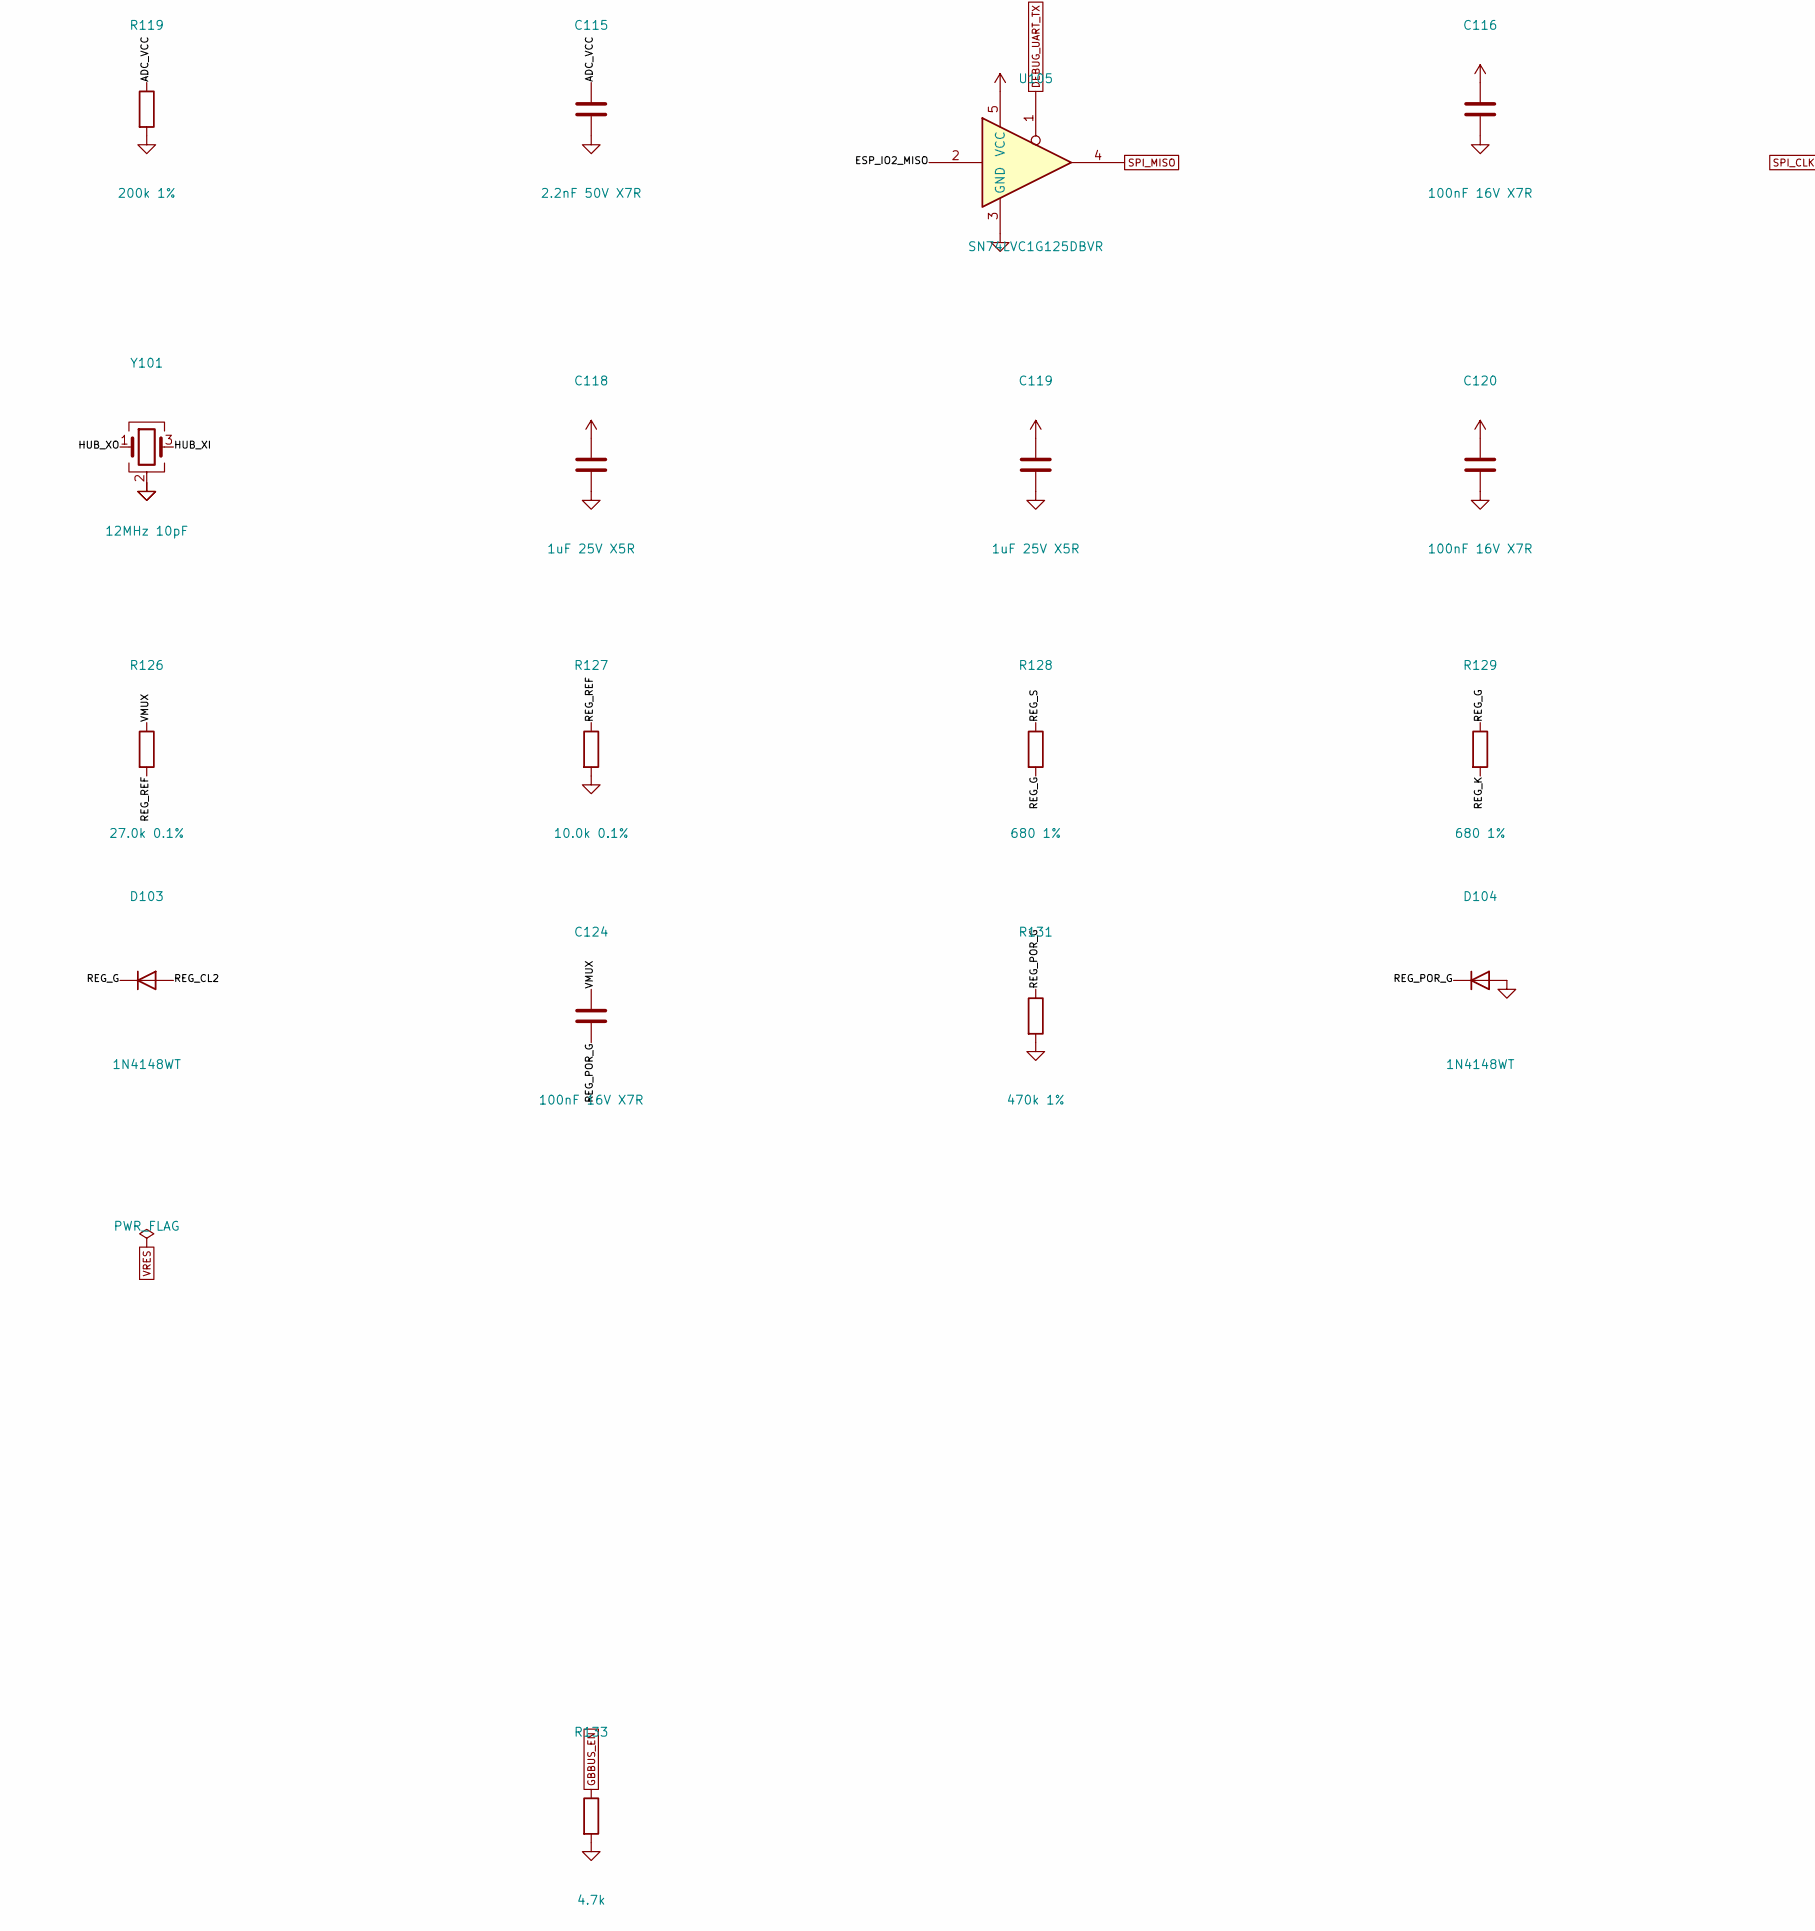
[picture p48: schematic radio.kicad_sch, Radio + console-safe power stage, part in row 2, column 1]

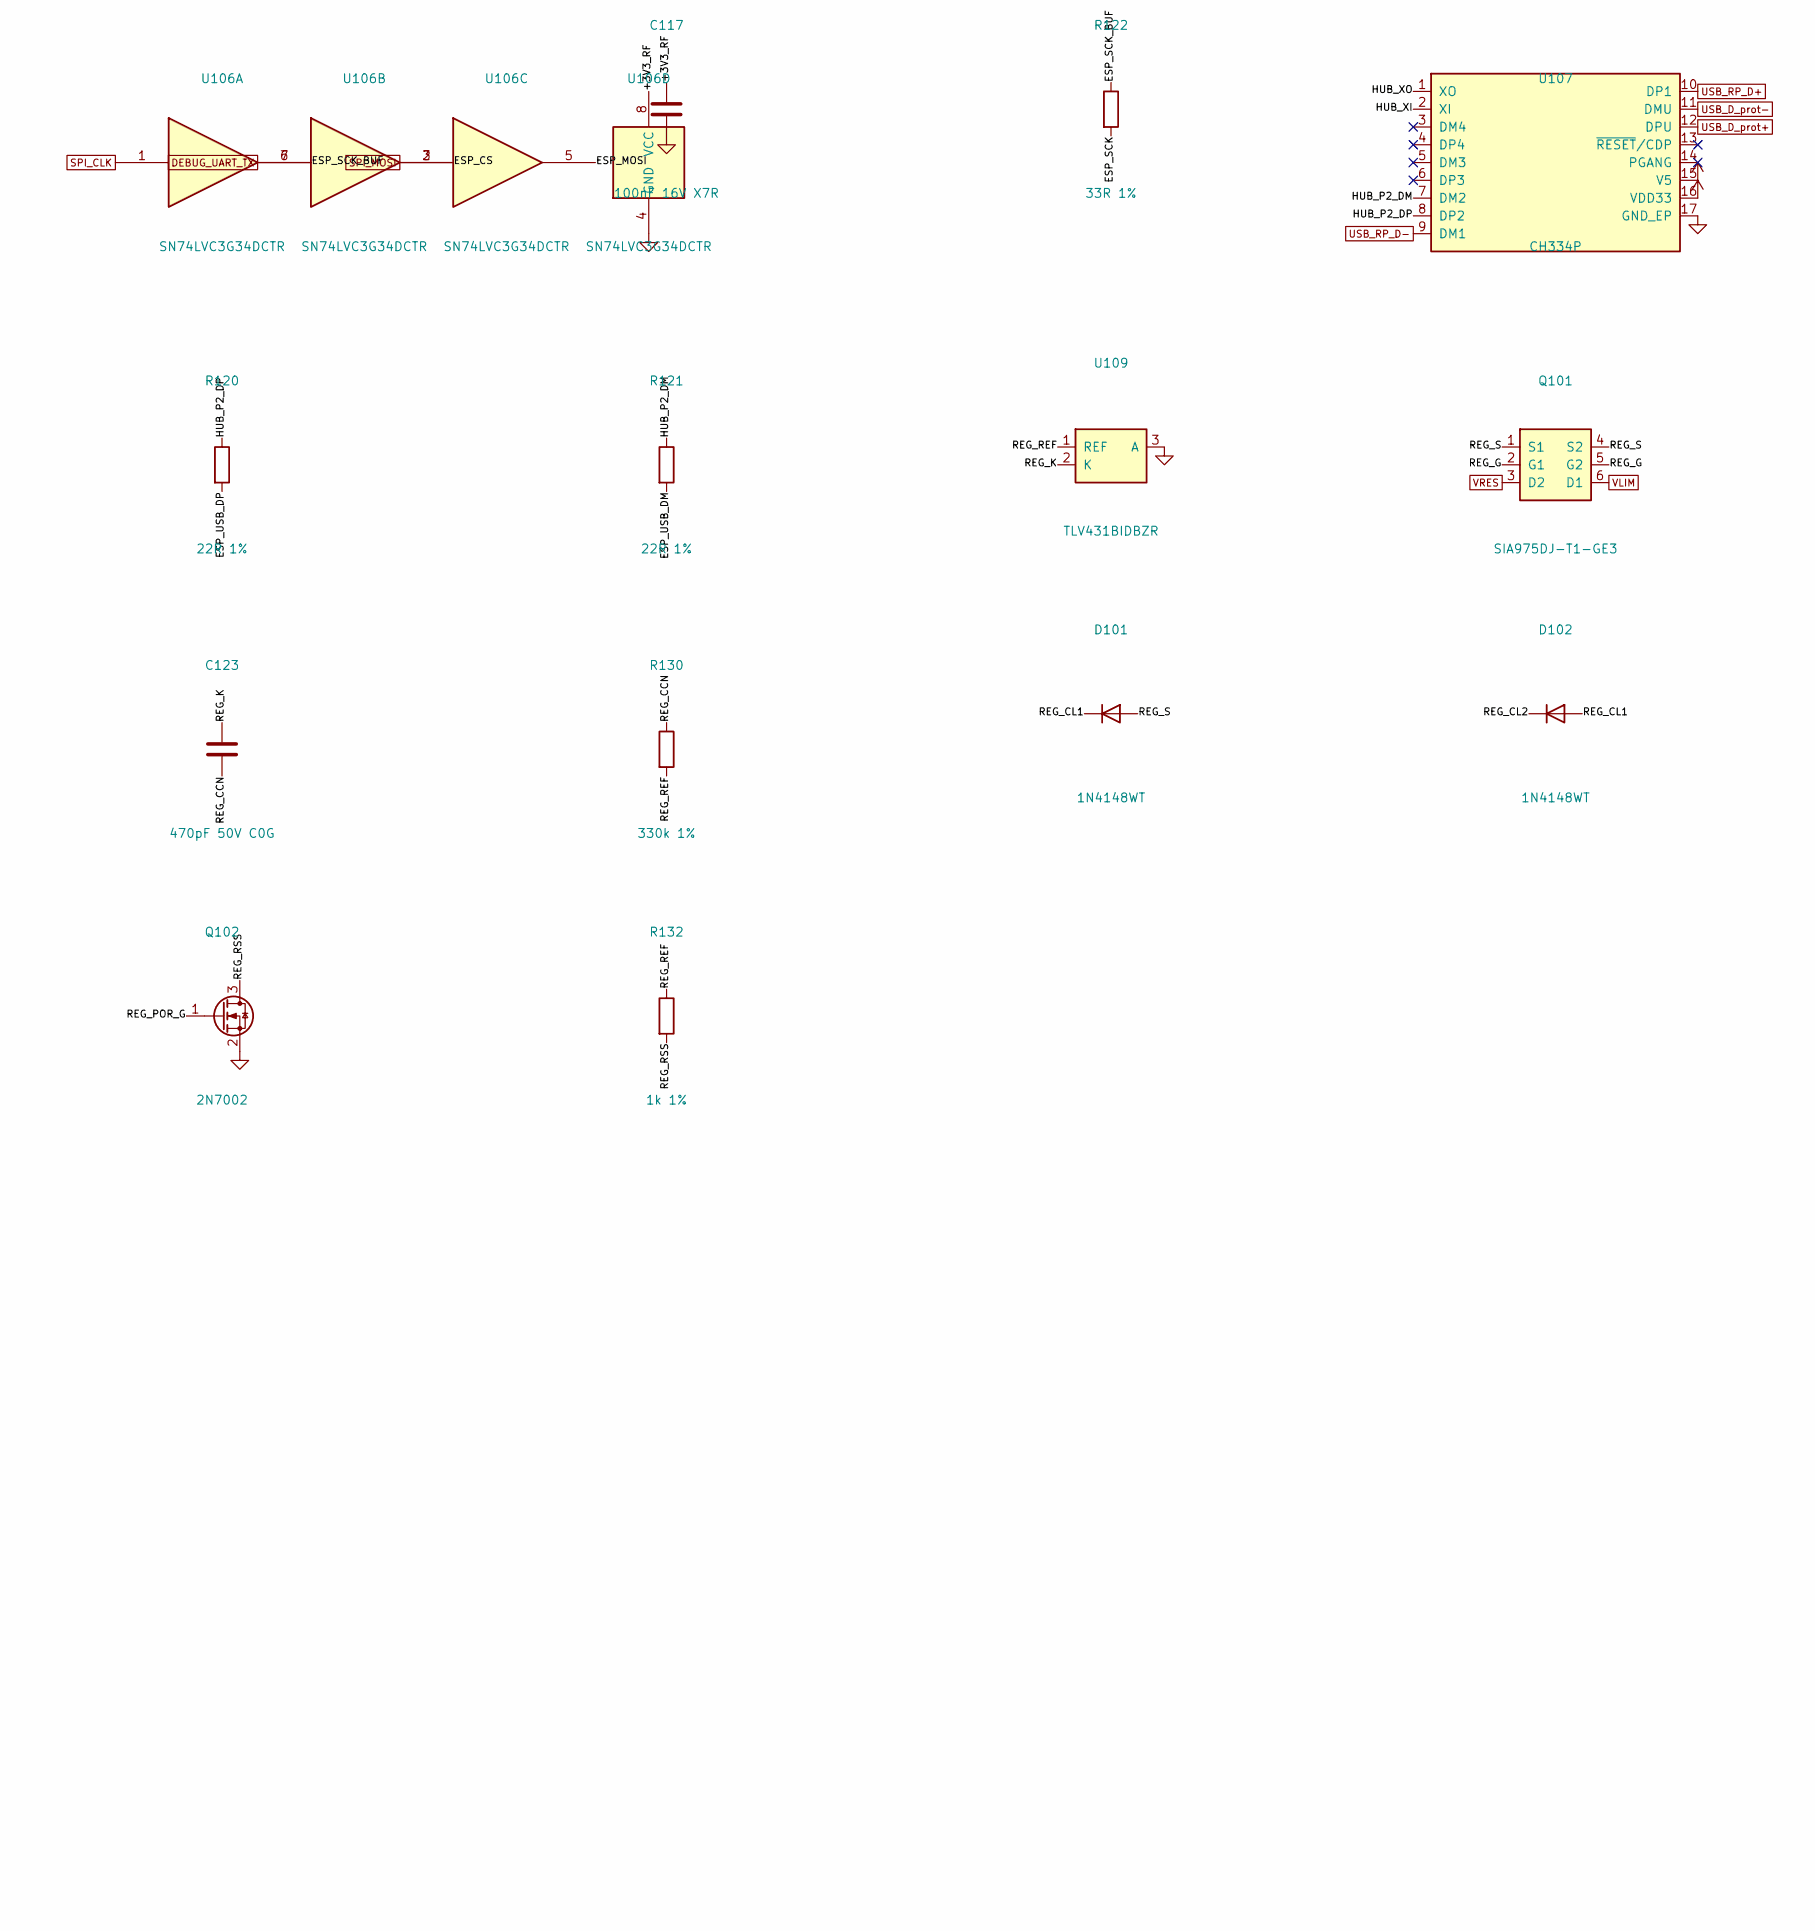
[picture p49: schematic radio.kicad_sch, Radio + console-safe power stage, part in row 2, column 2]

Parts:
C101, C102, C103, C104, C118, C119: 1uF 25V X5R; C_0402_1005Metric; LCSC C52923
C105, C106, C107: 330uF 6.3V 40mOhm T520B337M006ATE040; CP_EIA-3528-21_Kemet-B; LCSC C696806
C108, C109, C111: 10uF 10V X5R; C_0603_1608Metric; LCSC C19702
C110: 22uF 6.3V X5R; C_0603_1608Metric; LCSC C59461
C112, C113, C116, C117, C120, C122, C124: 100nF 16V X7R; C_0402_1005Metric; LCSC C1525
C114, C115: 2.2nF 50V X7R; C_0402_1005Metric; LCSC C84703
C121: 10nF 50V X7R; C_0402_1005Metric; LCSC C15195
C123: 470pF 50V C0G; C_0402_1005Metric; LCSC C76971
D101, D102, D103, D104: 1N4148WT; D_SOD-523; LCSC C27748
L101: 0.47uH 5.5A 26mOhm DFE201612E-R47M; L_Murata_DFE201610P; LCSC C668312
Q101: SIA975DJ-T1-GE3; Vishay_PowerPAK_SC70-6L_Dual; LCSC C141597
Q102: 2N7002; SOT-23; LCSC C8545
R101: 1.3k 1%; R_0402_1005Metric; LCSC C25866
R102: 510 1%; R_0402_1005Metric; LCSC C25123
R103: 180k 1%; R_0402_1005Metric; LCSC C25760
R104, R115: 100k 1%; R_0402_1005Metric; LCSC C25741
R108, R111, R112, R113, R114: 10k 1%; R_0402_1005Metric; LCSC C25744
R109: 511k 1%; R_0402_1005Metric; LCSC C64042
R110: 91k 1%; R_0402_1005Metric; LCSC C453777
R116, R118: 680k 1%; R_0402_1005Metric; LCSC C4131
R117, R119: 200k 1%; R_0402_1005Metric; LCSC C25764
R120, R121: 22R 1%; R_0402_1005Metric; LCSC C25092
R122: 33R 1%; R_0402_1005Metric; LCSC C25105
R123: 1.3M 1%; R_0402_1005Metric; LCSC C423245
R124: 1.0M 1%; R_0402_1005Metric; LCSC C26083
R125: 1.2M 1%; R_0402_1005Metric; LCSC C43675
R126: 27.0k 0.1%; R_0402_1005Metric; LCSC C723421
R127: 10.0k 0.1%; R_0402_1005Metric; LCSC C190095
R128, R129: 680 1%; R_0402_1005Metric; LCSC C137948
R130: 330k 1%; R_0402_1005Metric; LCSC C25778
R131: 470k 1%; R_0402_1005Metric; LCSC C25790
R132: 1k 1%; R_0402_1005Metric; LCSC C11702
R133: 4.7k; R_0402_1005Metric; LCSC C25900
U101: TPS2116DRLR; SOT-583-8; LCSC C3235557
U102: TPS2553DBVR; SOT-23-6; LCSC C55266
U103: TPS63802DLAR; TI_DLA0010A_VSON-HR-10_2x3mm_P0.5mm; LCSC C2845237
U104: ESP32-C3-MINI-1U-N4; ESP32-C3-MINI-1U; LCSC C2911374
U105: SN74LVC1G125DBVR; SOT-23-5; LCSC C23654
U106: SN74LVC3G34DCTR; SSOP-8_2.95x2.8mm_P0.65mm; LCSC C139356
U107: CH334P; QFN-16-1EP_3x3mm_P0.5mm_EP1.75x1.75mm; LCSC C5373042
U108: TLV3012BIDBVR; SOT-23-6; LCSC C20345924
U109: TLV431BIDBZR; SOT-23; LCSC C398375
Y101: 12MHz 10pF; Crystal_SMD_3225-4Pin_3.2x2.5mm; LCSC C20625731

Connections:
+3V3: C116.1, C118.1, C119.1, C120.1, U105.5 (VCC), U107.15 (V5), U107.16 (VDD33); also elsewhere on the board
/Radio/+3V3_RF: C110.1, C111.1, C112.1, C117.1, R104.1, R108.1, R109.1, R112.1, R113.1, R114.1, R115.1, U103.6 (VOUT), U104.3 (3V3), U106.8 (VCC)
/Radio/ADC_VCC: C115.1, R118.2, R119.1, U104.13 (IO1)
/Radio/ADC_VRES: C114.1, R116.2, R117.1, U104.12 (IO0)
/Radio/ESP_CS: U104.16 (IO10), U106.2
/Radio/ESP_EN: C113.1, R111.2, U104.8 (EN)
/Radio/ESP_IO2_MISO: R112.2, U104.5 (IO2), U105.2
/Radio/ESP_IO8: R113.2, U104.22 (IO8)
/Radio/ESP_IO9: R114.2, U104.23 (IO9)
/Radio/ESP_MOSI: U104.21 (IO7), U106.5
/Radio/ESP_SCK: R122.2, U104.20 (IO6)
/Radio/ESP_SCK_BUF: R122.1, U106.7
/Radio/ESP_USB_DM: R121.2, U104.26 (IO18)
/Radio/ESP_USB_DP: R120.2, U104.27 (IO19)
/Radio/HUB_P2_DM: R121.1, U107.7 (DM2)
/Radio/HUB_P2_DP: R120.1, U107.8 (DP2)
/Radio/HUB_XI: U107.2 (XI), Y101.3
/Radio/HUB_XO: U107.1 (XO), Y101.1
/Radio/LIM_FAULT_N: R104.2, U102.4 (~FAULT), U104.18 (IO4)
/Radio/LIM_ILIM: R103.1, U102.5 (ILIM)
/Radio/MUX_PR1: R101.2, R102.1, U101.4 (PR1)
/Radio/PG_REF: C121.1, U108.4 (IN-), U108.5 (REF)
/Radio/PG_SENSE: R123.2, R124.1, R125.2, U108.3 (IN+)
/Radio/REG_CCN: C123.2, R130.1
/Radio/REG_CL1: D101.1 (K), D102.2 (A)
/Radio/REG_CL2: D102.1 (K), D103.2 (A)
/Radio/REG_G: D103.1 (K), Q101.2 (G1), Q101.5 (G2), R128.2, R129.1
/Radio/REG_K: C123.1, R129.2, U109.2 (K)
/Radio/REG_POR_G: C124.2, D104.1 (K), Q102.1 (G), R131.1
/Radio/REG_REF: R126.2, R127.1, R130.2, R132.1, U109.1 (REF)
/Radio/REG_RSS: Q102.3 (D), R132.2
/Radio/REG_S: D101.2 (A), Q101.1 (S1), Q101.4 (S2), R128.1
/Radio/RF_EN: R125.1, U103.1 (EN), U108.1 (OUT)
/Radio/RF_FB: R109.2, R110.1, U103.4 (FB)
/Radio/RF_L1: L101.1, U103.9 (L1)
/Radio/RF_L2: L101.2, U103.7 (L2)
/Radio/RF_PG: R108.2, R111.1, U103.5 (PG)
/Radio/USB_PWR_ST: R115.2, U101.8 (ST), U104.19 (IO5)
/Radio/VMUX: C103.1, C124.1, R126.1, U101.2 (VOUT), U101.7 (VOUT), U102.1 (IN), U102.3 (EN)
DEBUG_UART_TX: U105.1, U106.6; also elsewhere on the board
GBBUS_EN: R133.1; also elsewhere on the board
GND: C101.2, C102.2, C103.2, C104.2, C105.2, C106.2, C107.2, C108.2, C109.2, C110.2, C111.2, C112.2, C113.2, C114.2, C115.2, C116.2, C117.2, C118.2, C119.2, C120.2, C121.2, C122.2, D104.2 (A), Q102.2 (S), R102.2, R103.2, R110.2, R117.2, R119.2, R124.2, R127.2, R131.2, R133.2, U101.1 (GND), U102.2 (GND), U103.2 (MODE), U103.3 (AGND), U103.8 (GND), U104.1 (GND), U104.2 (GND), U104.11 (GND), U104.14 (GND), U104.36 (GND), U104.37 (GND), U104.38 (GND), U104.39 (GND), U104.40 (GND), U104.41 (GND), U104.42 (GND), U104.43 (GND), U104.44 (GND), U104.45 (GND), U104.46 (GND), U104.47 (GND), U104.48 (GND), U104.49 (GND), U104.50 (GND), U104.51 (GND), U104.52 (GND), U104.53 (GND), U105.3 (GND), U106.4 (GND), U107.17 (GND_EP), U108.2 (V-), U109.3 (A), Y101.2 (G), Y101.4 (G); also elsewhere on the board
SPI_CLK: U106.1; also elsewhere on the board
SPI_MISO: U105.4; also elsewhere on the board
SPI_MOSI: U106.3; also elsewhere on the board
USB_D_prot+: U107.12 (DPU); also elsewhere on the board
USB_D_prot-: U107.11 (DMU); also elsewhere on the board
USB_RP_D+: U107.10 (DP1); also elsewhere on the board
USB_RP_D-: U107.9 (DM1); also elsewhere on the board
VBUS: C101.1, R101.1, U101.3 (VIN1), U101.5 (MODE); also elsewhere on the board
VCC: C102.1, R118.1, U101.6 (VIN2); also elsewhere on the board
VLIM: C104.1, Q101.6 (D1), U102.6 (OUT)
VRES: C105.1, C106.1, C107.1, C108.1, C109.1, C122.1, Q101.3 (D2), R116.1, R123.1, U103.10 (VIN), U108.6 (V+)

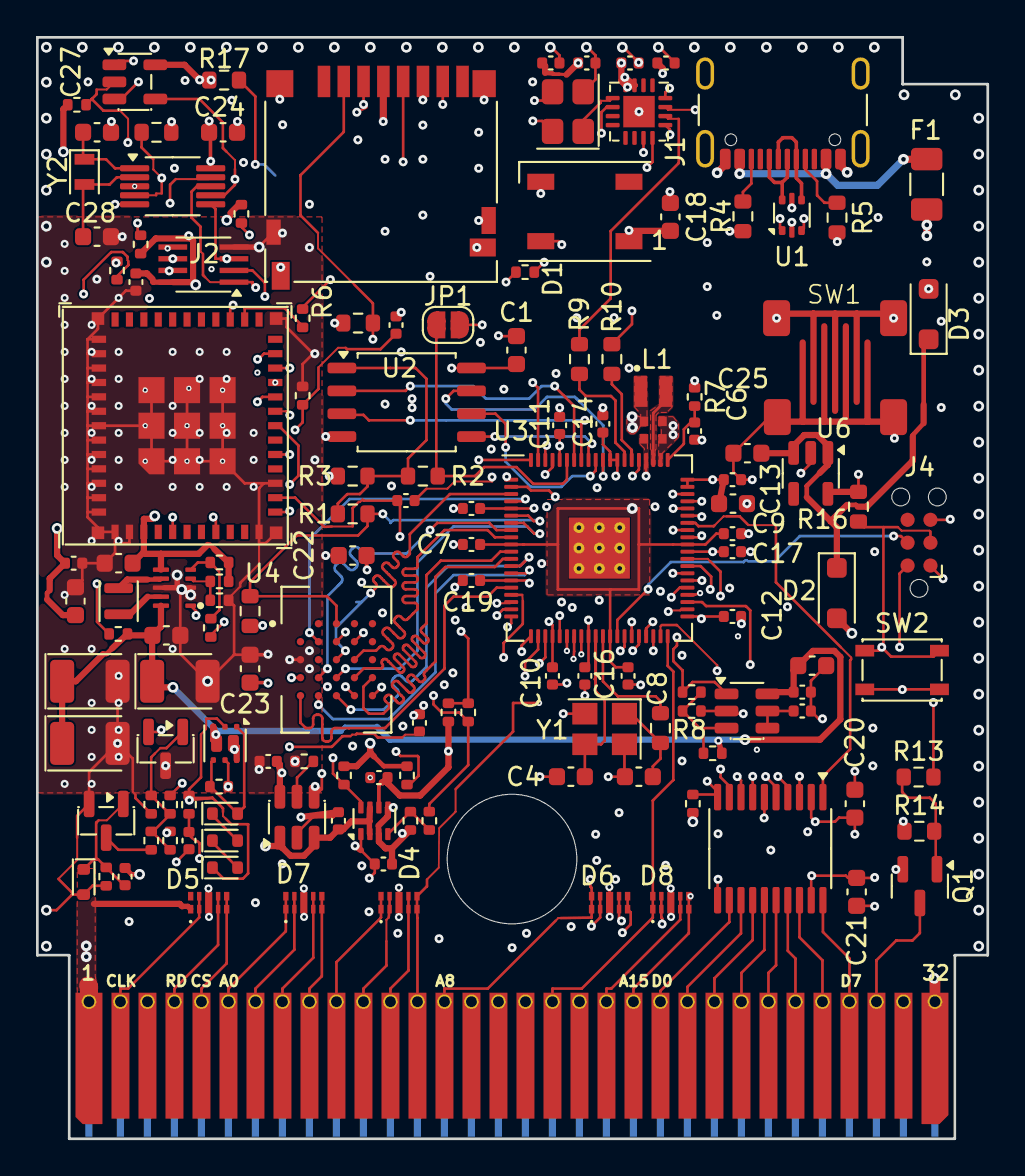
[picture p50: board GameboyCartridgeV2.1.kicad_pcb from above]

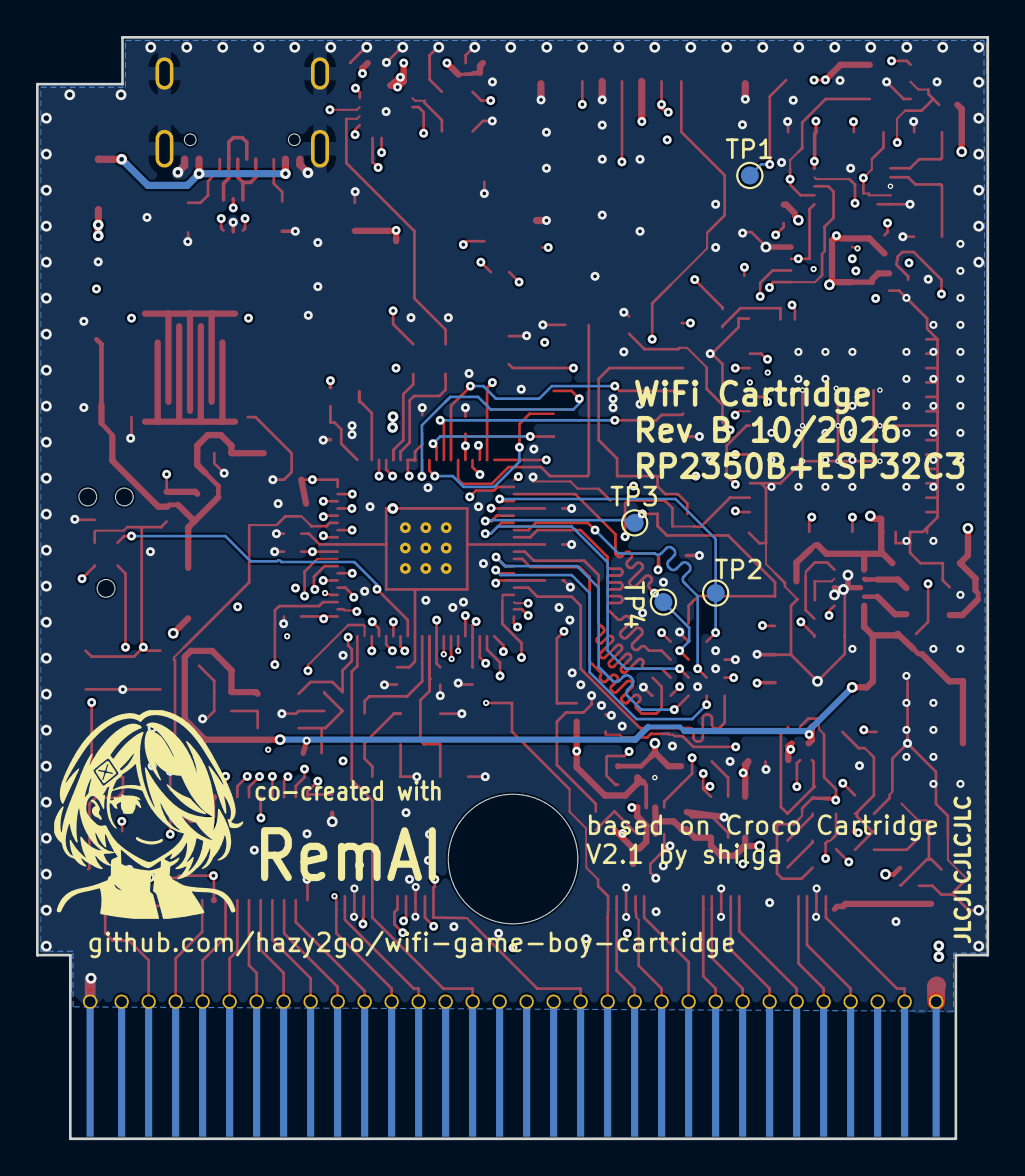
[picture p51: board GameboyCartridgeV2.1.kicad_pcb from below]

Board: 6 copper layers, 52.8 x 61.2 mm, 146 parts (4 on the bottom side), 133 nets.
