hazy2go/wifi-game-boy-cartridge/(commit log)

2026-10-13 sim: power-path simulation (original vs proposed), logbook
2026-10-13 docs: Rev B architecture, pin budget, link + flashing plan
2026-10-13 logbook: BQ24075 choice, tolerance corners, pin budget, KiCad baseline
2026-10-13 hw: schematic generator tooling, top-side occupancy map; logbook
2026-10-13 audit loop: independent pyref integrator, sim audit A1-A5, KiCad baseline gate; logbook
2026-10-13 audit: C power manager co-sim (A6), firmware corner sweep (A5), calibration budget (A7); logbook
2026-10-13 regulator: transistor-level sim with vendor models (fetch script, not redistributed), anti-windup search, A8 audit (not yet passing); radio block netlist + checkers from design pass; logbook
2026-10-13 regulator: 3-diode clamp, power-on hold, TPS2553 vendor model in transients; A8 re-run (hot-plug/burst pass, GM fails); checker fixes (all 0 dB/-180 crossings, 200 pts/dec, per-process files); A8.6 T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
2026-10-13 regulator: oscillation confirmed with TI TPS2553 model, root cause (local TLV431 loop via gate integrator), round 3 log, round 4 candidates; logbook
2026-10-13 regulator rounds 4-5: X (cathode integrator) kept, Y dropped, wind-up clamp experiment; logbook
2026-10-13 regulator closed: round 6 (Cc 470p, Rc 330k on cathode), A8 all pass with GM >= 13 dB, TLV431 model vs datasheet test, regulator added to netlist (custom TLV431DBZ/SiA975DJ symbols), sim-vs-netlist c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
2026-10-13 system audit A1-A7 against the TLV431B regulator (all pass; weak console 4.449 -> 4.544 V), sim/netlist supervisor drift fixed, fw watch sweep; logbook
2026-10-13 schematic: radio sheet in the KiCad project (symbol lib generator, Croco edits applied + verified, PWR_FLAG, layout), KiCad lib env + re-recorded baseline, checker fixes (length-normalised fingerprin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
2026-10-13 footprints: TPS63802 DLA0010A from TI land pattern, ESP32-C3-MINI-1U from Espressif official lib, both audited vs datasheets and cross-checked vs LCSC; ERC clean; logbook
2026-10-14 board: scripted schematic->PCB update (70 footprints staged, nets, rip of USB_D_prot pair), deterministic sheet UUIDs, U106 to SM8 for clearance; parity pass; logbook
2026-10-14 coin cell removed (DNP), RTC VBAT to GND per datasheet, power-symbol + dnp support in croco edit tool, board updated (BT1 off, +BATT ripped); logbook with save/RTC findings + correction
2026-10-14 layout: placement tooling (fit_part, place.py + placement.json), WiFi module placed in the former coin-cell area, BT1 GND stitching removed
2026-10-14 J3/R11 debug UART header DNP + off board (ESP CS stub), free-space map counts placed new parts, sim: firmware-configured vs actual reservoir C, T520B reservoir runs
2026-10-14 T520B reservoir (audits A1-A8 pass at -20% C), sim: firmware vs actual reservoir C, footprint swap in update_pcb, autoplace tool (result rejected, reverted), logbook
2026-10-14 layout WIP: lift tool, Croco LDO/diode cluster lifted, lower-left corner cleared; area accounting; logbook
2026-10-14 option A area check: does not fit; SOD-523 clamp diodes; geometry plot tools; logbook
2026-10-14 board: 4 -> 6 layers, JLC06081H-7628 stackup (L1-L2 spacing unchanged), power planes moved In2 -> In4, In2/In3 free for signals
2026-10-14 layout: rip 41 slow Croco signal nets off the outer layers for inner-layer re-route (core HyperRAM/QSPI/USB/xtal/power routing kept)
2026-10-14 layout: all parts placed on the 6-layer board (groups + autoplace), D1 restored, logbook
2026-10-14 routing pass 1: Freerouting 2.5 on 6 layers (rules 0.15/0.15, vias 0.5/0.2, Power class 0.35), own SES importer (KiCad's fails silently); unconnected 293 -> 41
2026-10-14 routing: own inner-layer finisher (A* on In2/In3, via legality on all signal layers, reuses existing vias), BUTTON re-routed off the SW1 contact pattern; unconnected 27 -> 15
2026-10-14 routing: finisher fixes (via clearance, fan-out BFS, direct connections), F.Cu GND pour; 11 open; logbook
2026-10-14 routing pass 3: slow Croco nets re-routed with the stuck ones, orphan +5V plane removed; 7 open
2026-10-14 routing: finisher base raster for 0.15 mm tracks; 3 open
2026-10-14 routing WIP: FB/PG resistor block re-arranged, USB_PWR_ST moved to ESP IO5 (pin 19), ADC_VCC divider moved to the VCC source; 5 open
2026-10-14 gate S1: full-system simulation with a Game Boy ROM (Peanut-GB + mailbox + RP2350/ESP models + shipped power manager + power plant), all pass; routing WIP; logbook
2026-10-14 design calcs: USB_PWR_ST on ESP IO5 (pin 19)
2026-10-14 routing: finisher enforces hole-to-hole for new vias; BUTTON re-routed clear of SW1; 7 open, no new copper DRC errors except one VRES via pair
2026-10-14 routing: GND via-in-pad (U5, C102 area), +3V3_RF/LIM_FAULT_N/GB_CS re-routed, VCC to U101 via In4 VCC plane extension + one via (router's 108 mm detour rejected), GB_A2 jogged; 5 open; tools pad_to_p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
2026-10-14 R123 (1.3M PG_SENSE top resistor) moved next to U108 pin 3, VRES end drops onto the B.Cu VRES run; PG_SENSE connected; 1 open (GB_A15)
2026-10-14 step 3: silkscreen (70 visible LCSC fields hidden, new refs to Fab, outlines clipped, 20 Croco refs moved), stray +3V3 via removed; gate: ERC/DRC/unconnected/parity all PASS
2026-10-14 docs: README section for the Rev B fork (status, board, radio, power, what is proven, credits); ARCHITECTURE/hw README status and parts brought up to date; REDESIGN marked historical
2026-10-14 JLC order files: BOM (live-checked, 3 out-of-stock Croco chips replaced, C27/C28 value fix), CPL with pad-matched rotations/offsets, Gerbers+drill, ORDER.md; gate PASS
2026-10-14 docs: status = order files ready, waiting for the dev-board calibration measurement
2026-10-14 back silkscreen: WiFi Cartridge Rev B name, fork URL, Croco credit; Gerbers regenerated; gate PASS
2026-10-14 logbook: antenna placement check, RF concern, added to dev-board test
2026-10-14 logbook: antenna fit wording (avoid USB-C)
2026-10-14 correction: MINI-1U antenna connector is MHF III (W.FL), not U.FL; ORDER.md + logbook
2026-10-14 parts pin audit vs JLC records (all agree), review notes: console-voltage sweep reproduced (VSRC/VDPM sim params), hold point added, zones refilled+saved, GPIO46 firmware rule; logbook
2026-10-14 console-voltage range: 26.7k floor tried and rejected (A8.5 burst-after-idle dips below 4.5 V), R126 stays 27.0k; firmware rail watch lowered to 4.45/4.48 V (backstop below floor); A1-A8, S1 ALL PASS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
2026-10-14 sim/power README: reservoir row = T520B
2026-10-14 logbook: DMG 5V estimated from Gekkio's power-board schematics; console measurement now optional
2026-10-14 ORDER.md: console 5V hold point now optional
2026-10-14 ORDER.md: antenna pick Ebyte TX2400-FPC3-2509 (IPEX3)
2026-10-14 README rewritten as our own: board renders, demo, proof, credits, licenses
2026-10-14 XIAO bench firmware for hold points 1-2: a7_cal (RF calibration timing), rf_logger + rf_host.py (antenna RSSI/throughput)
2026-10-14 Back silk: RemAI avatar + 'co-created with RemAI' replace OSHW/Croco logos; Gerbers + renders updated
2026-10-14 SPI link protocol v1: spec, C reference (esp_link), byte-level sim + S1.6/S1.7, Rust test vectors, WIFICART opt-in
    Claude-Session: https://claude.ai/code/session_01F5zMMQgMFiMCad54U85DYT
2026-10-14 ESP32-C3 app (step 4): SPI slave link, commands 01-07, TX admission hook, MTU 340, light-sleep park; gbwifi shared with sysim; S1.8
    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
2026-10-14 Power audits at 1.4 mA park (ALL PASS); WIFICART anywhere in bank 0; GBDK-2020 library + demo, gate S1.9
    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
2026-10-14 End-to-end audit: link session + payload wipe, MSS clamp instead of MTU, TX queue, light-sleep fixes, reconnect, 8 s job budget, BOOT = A7 time; sim models the app faithfully (S1.10/S1.11); audit log
    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
2026-10-14 Hardware gate ALL PASS on KiCad 10.0.6; fab Gerbers verified current; lib-table note
    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
2026-10-14 USB guard against D3 leakage (datasheet checked), XIAO board profile + console job command, docs
    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
2026-10-14 R101/R102 1.3k/510: same USB threshold, 3x D3-leakage margin; BOM/CPL regenerated; all gates re-run
    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
2026-10-14 Docs for the remaining audits (ORDER.md shell cut-out, CLAUDE.md height tool, sim README); untrack dSYM
    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
2026-10-15 XIAO bench: a7_cal fix (power up the WiFi domain before calibrating), new cal_current app, first A7 results
    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
2026-10-15 XIAO bench: rf_logger fix (11b rate before WiFi start), antenna first look, 0 brown-outs in the meter run
    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
2026-10-15 XIAO bench: radio app works on real WiFi; boot to app_main 45 ms on the power-on path
    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
2026-10-15 LOGBOOK: correction, boot fit depends on the boot current
    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
2026-10-16 Rev B: fixes from the wallet cart's JLC check and datasheet review
    - JLC gate (verify/jlc_check.py): top-edge GND vias 0.06 mm inward, copper-to-edge
    rule 0.2 mm with a J5 exemption (.kicad_dru), back URL/credit text 1.0 mm. PASS.
    - Radio-area ground: F.Cu GND pour, 56 stitching vias, one via per U104 centre
    sub-pad, vias at U103 GND pins, C106, U106.4. GND vias 214 -> 285.
    - RP2350 VREG_LX keepout on In1-In4; DEBUG_UART_TX and LED_DIN rerouted around it.
    - R110 -> C453777 (C4147 below JLC's minimum buy); make_bom now checks minimum buy.
    - R133 4.7k GBBUS_EN pull-down (TXB0108 OE).
    - Y1 -> ABM8-272-T3 C20625731.
    - USB upstream D+ moved onto In2 with D-: 2 vias each, 12.42 / 11.84 mm.
    - A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
2026-10-16 Y101 hub crystal -> ABM8-272-T3, same part as Y1
    CH334 datasheet gives no ESR limit (only ~16 pF internal load, 12 MHz), so the
    old part was within spec; swapped for 50 ohm ESR margin and one feeder fewer.
    Gates re-run, LOGBOOK 2026-10-16 12:35.
    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
2026-10-16 Order quantity: 2 assembled boards; BOM checked for 2 (L1 still short)
    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
